Balestrino/UV-Curing/CuringBox/CuringBox.pptx

## CuringBox

Light source and Bioreactor holder

## Slide 2

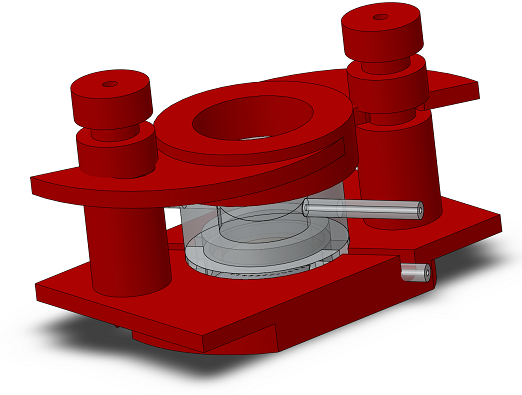
[picture p1: figure]
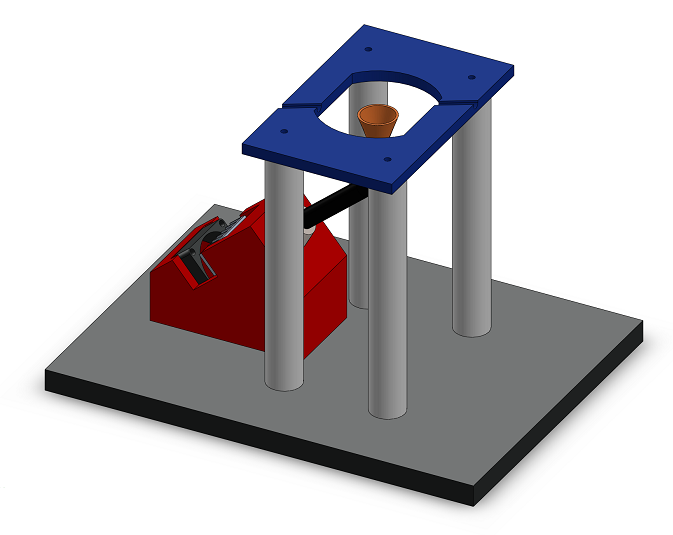
[picture p2: figure]

## Slide 3

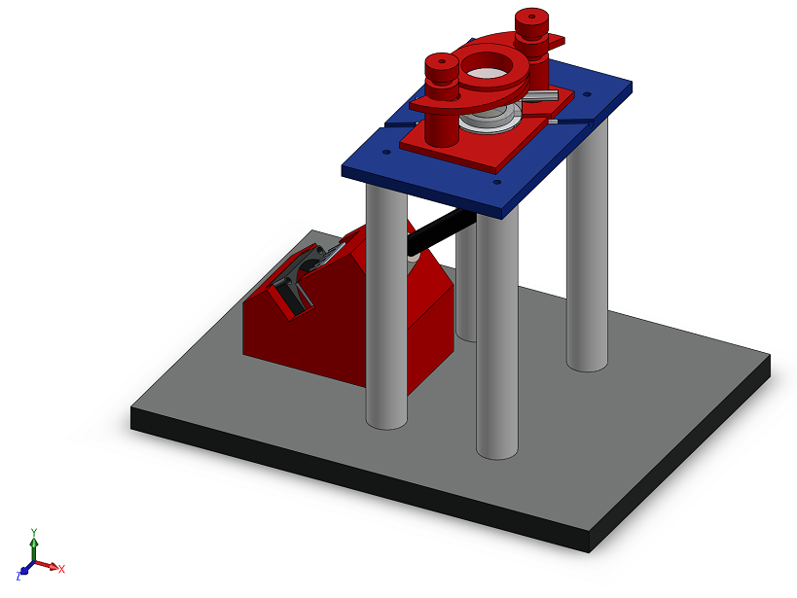
[picture p3: figure]

## Slide 4

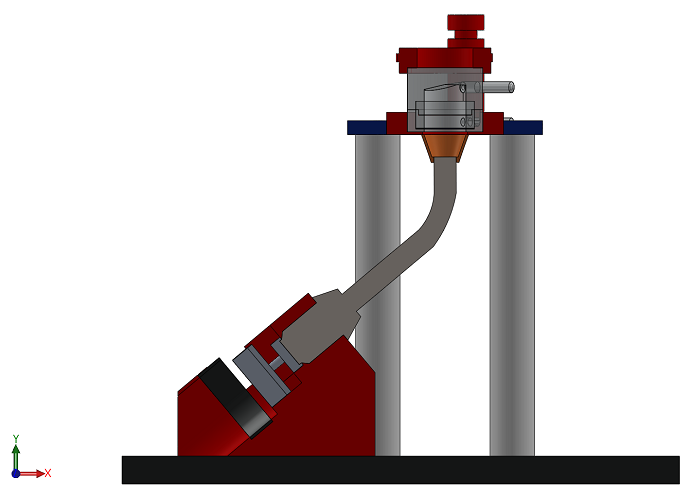
[picture p4: figure]

Blue LED + heatsink

Dissipation fan

Light guide
