Balestrino/UV-Curing/CuringBox/LiveBox 1/Patent/Claim list.docx

1. Technical description
  a. Technical drawings of bioreactor components + written description
  b. Modes of use
2. Claims
  a. Removable glass bottom allowing for
    i. direct cell culture on it
    ii. in situ polymerisation of photo-crosslinkable materials (hydrogels, …)
    iii. in-situ photo-stimulation of light-sensitive materials (hydrogel, sensors, ROS generators, …)
    iv. Live imaging through transparent bottom during dynamic cultures of 2D/3D cellular constructs cultivated on the glass discs or onto the membrane
  b. Support for 2D/3D static and dynamic cell cultures with a sensorised culture chamber resembling 24 well plate volume allowing for cell expansion (i.e. cell confluence) and subsequent dynamic cultures in two different configurations
    i. Conventional culture on the well bottom
    ii. Transwell configuration mimicking 12 transwell insert surface
    iii. Monitoring through electrical measures (TEER measurements, required only for interface cultures)
  c. Flow: 2 inlets / 2 outlets (one inlet/outlet pair above the interface and one below)
    i. Single side
    ii. Double side (ALI or LLI cell culture)
    iii. 3D Construct perfusion (sigmoidal → upper in/lower out preferred embodiment)
  d. Re-usable glass housing
3. SoA
  a. Sensorised culture supports allowing for both
    i. cell expansion (i.e. cell confluence) and subsequent dynamic cultures without the need of transferring pre-expanded construct from static culture devices
    ii. Live imaging

Live Imaging = in situ imaging of the three-dimensional (3D) culture environment using microscopy. The visualisation of cell response to their environment, in real time, helps to further elucidate the influences of biomaterial surface features, scaffold architectures, and culture parameters (e.g. flow induced shear) on cell response and growth of new tissue(s).
