Balestrino/UV-Curing/CuringBox/LiveBox 1/Figure A - TB.pptx

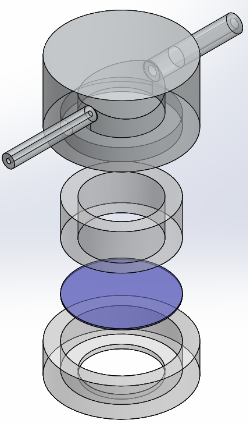
[picture p12: figure]

4

3

2

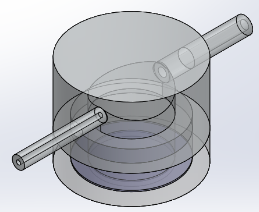
[picture p13: figure]

1

5
