Balestrino/UV-Curing/CuringBox/LiveBox 1/Figure B - LiveBox1.pptx

5

3

2

1

7


6

4

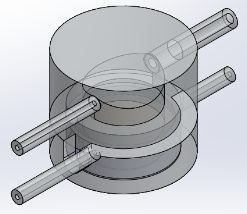
[picture p14: figure]
