Balestrino/UV-Curing/CuringBox/TB/3D view TB esploso.tif

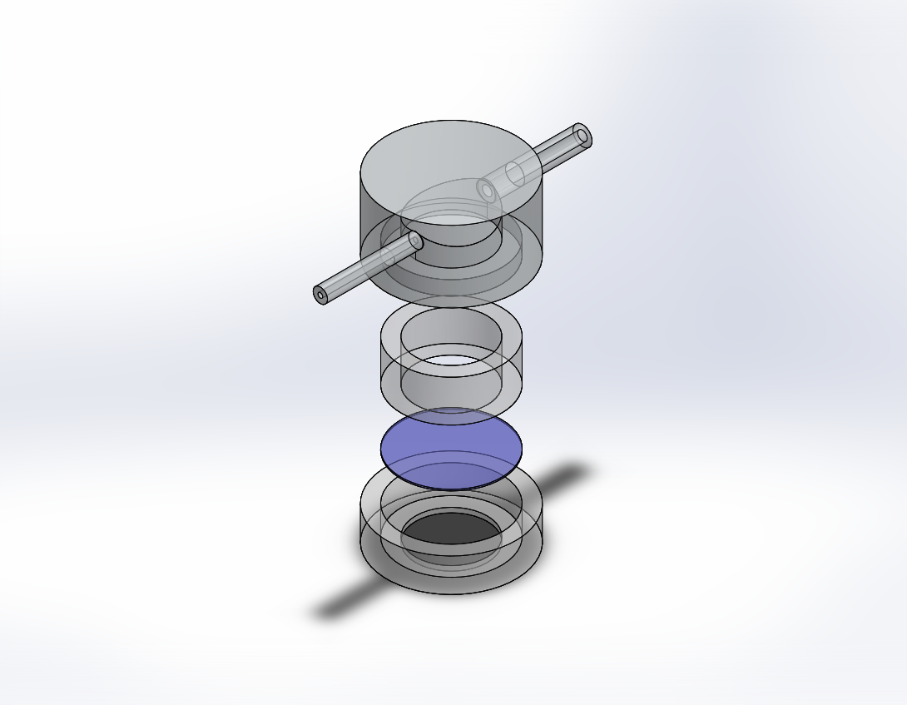
CuringBox/TB/3D view TB esploso.tif
