Balestrino/UV-Curing/CuringBox/TB/3D view TB.TIF

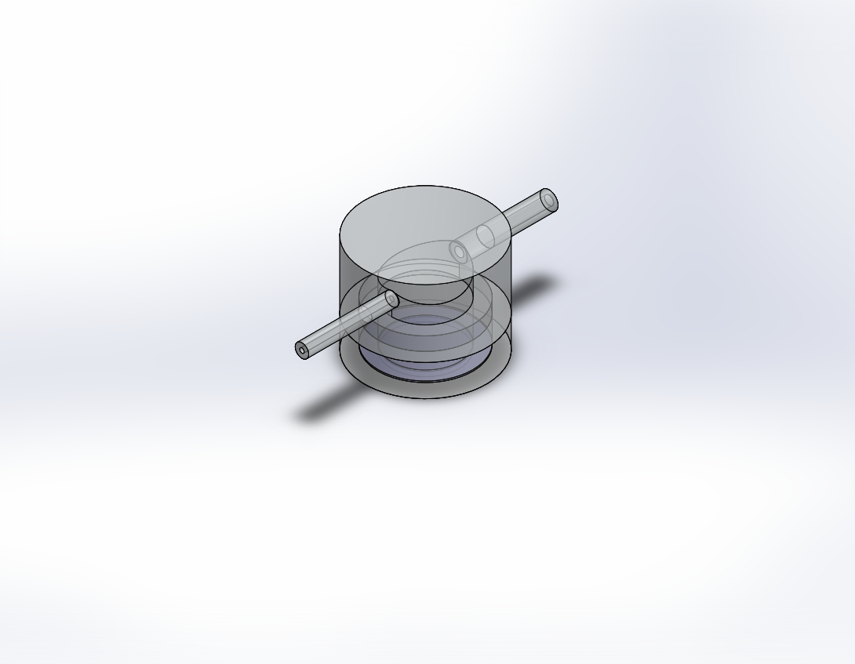
CuringBox/TB/3D view TB.TIF
