Balestrino/UV-Curing/CuringBox/Light source/Assembly - Light source.SLDASM

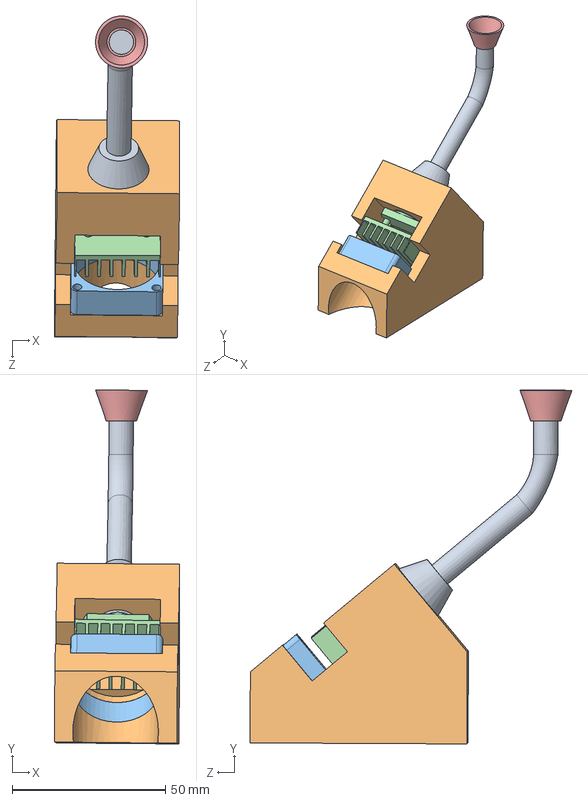
[picture p17: CAD file, 2013-10-29]
CuringBox/Light source/Assembly - Light source.SLDASM
41.0 x 115.5 x 105.1 mm
OpticFiber
Base
Dissipation fan
LED+heatsink
Rubber cone
