Balestrino/UV-Curing/CuringBox/LiveBox 1/PDMS assembly/3D view live box 1.SLDASM

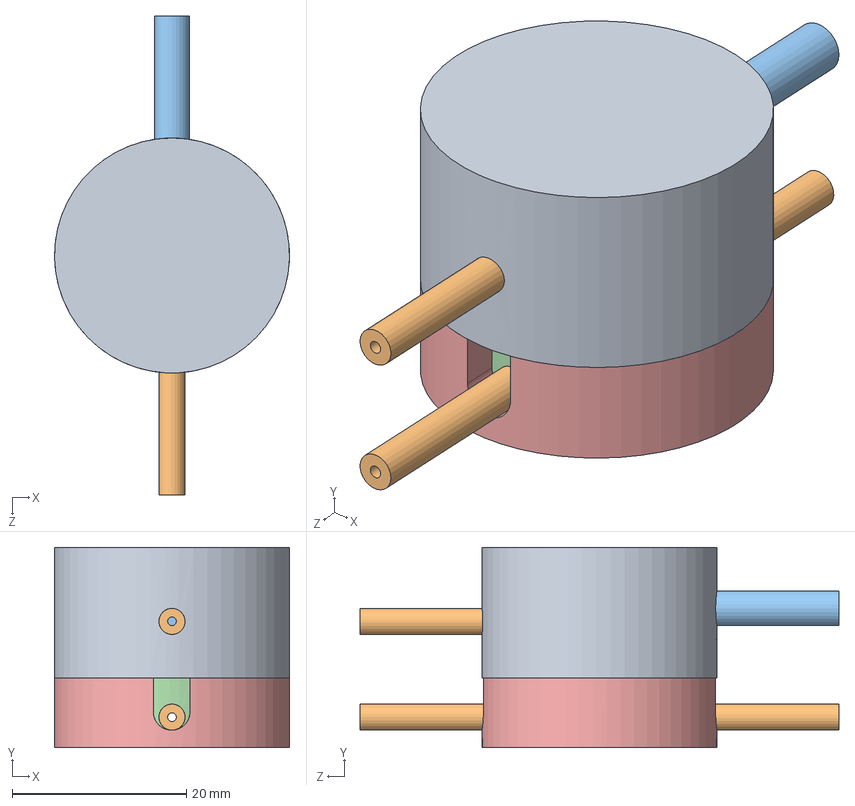
[picture p18: CAD file, 2013-10-29]
CuringBox/LiveBox 1/PDMS assembly/3D view live box 1.SLDASM
27.0 x 23.0 x 55.0 mm
Top
3x1 x 3
4x2
Inner bottom
Bottom
Inner up
glass bottom
Membrane
