Balestrino/UV-Curing/DrivingBox/arduino nano290313/MINIUSB - MEASURED.SLDASM

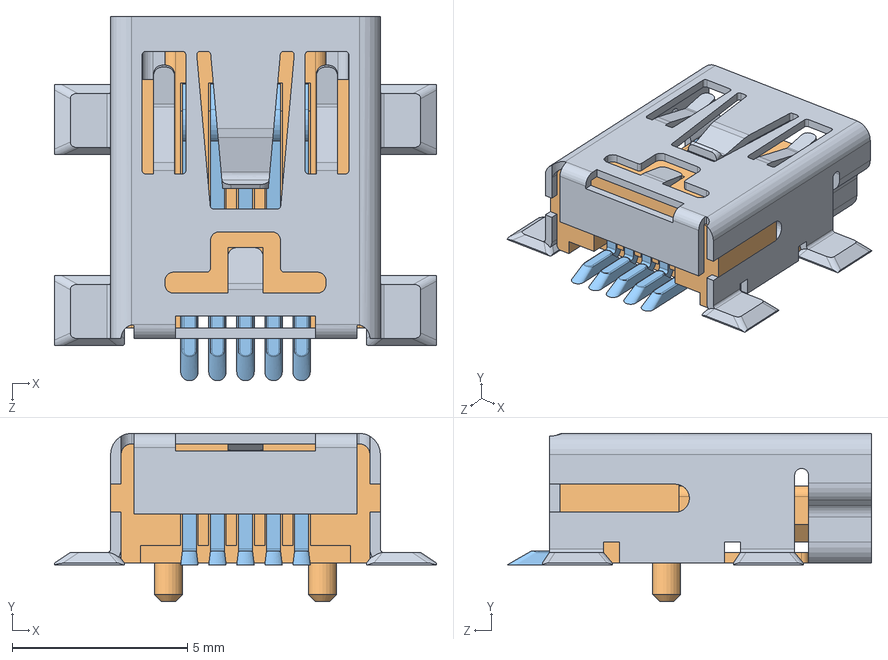
[picture p19: CAD file, 2013-10-29]
DrivingBox/arduino nano290313/MINIUSB - MEASURED.SLDASM
10.9 x 4.80 x 10.4 mm
MINIUSBSHELL
MINIUSBCORE
MINI USB CONTACT x 5
