Balestrino/UV-Curing/CuringBox/Assembly-CuringBox.SLDASM

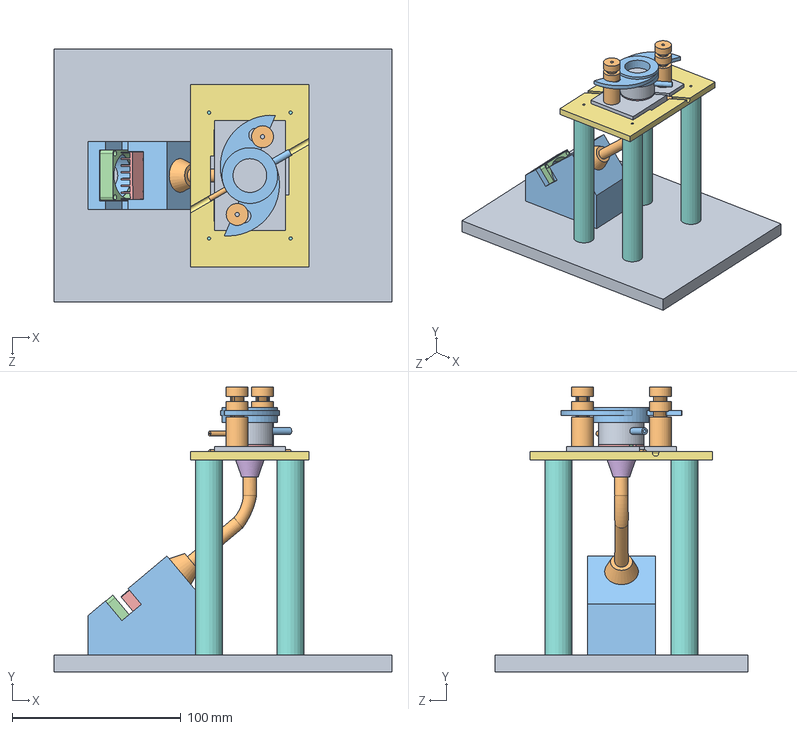
[picture p20: CAD file, 2013-10-29]
CuringBox/Assembly-CuringBox.SLDASM
200.0 x 168.5 x 150.0 mm
Basement
OpticFiber
Base
Dissipation fan
LED+heatsink
Rubber cone
Bioreactor holder
Column x 4
Top
3x1 x 3
4x2
Inner bottom
Bottom
Inner up
glass bottom
Membrane
mycroscope clamp base
mycroscope clamp colonna x 4
mycroscope clamp ali LVB1
