Balestrino/UV-Curing/CuringBox/LiveBox 1/PDMS assembly/3Dview-Inner bottom.SLDPRT.SLDASM

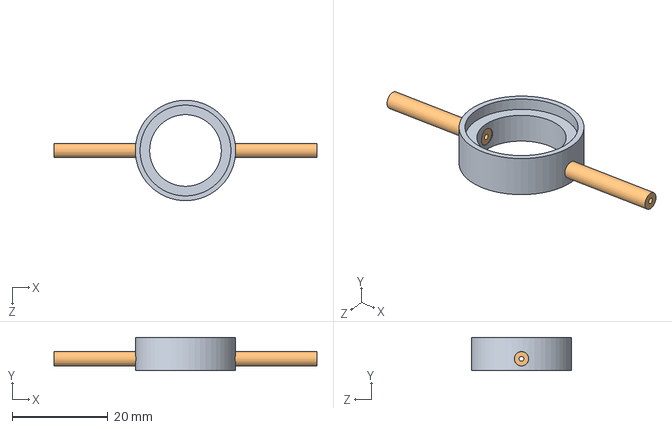
[picture p21: CAD file, 2013-10-29]
CuringBox/LiveBox 1/PDMS assembly/3Dview-Inner bottom.SLDPRT.SLDASM
55.0 x 7.00 x 21.0 mm
Inner bottom
3x1 x 2
