Balestrino/UV-Curing/CuringBox/TB/3D view TB.SLDASM

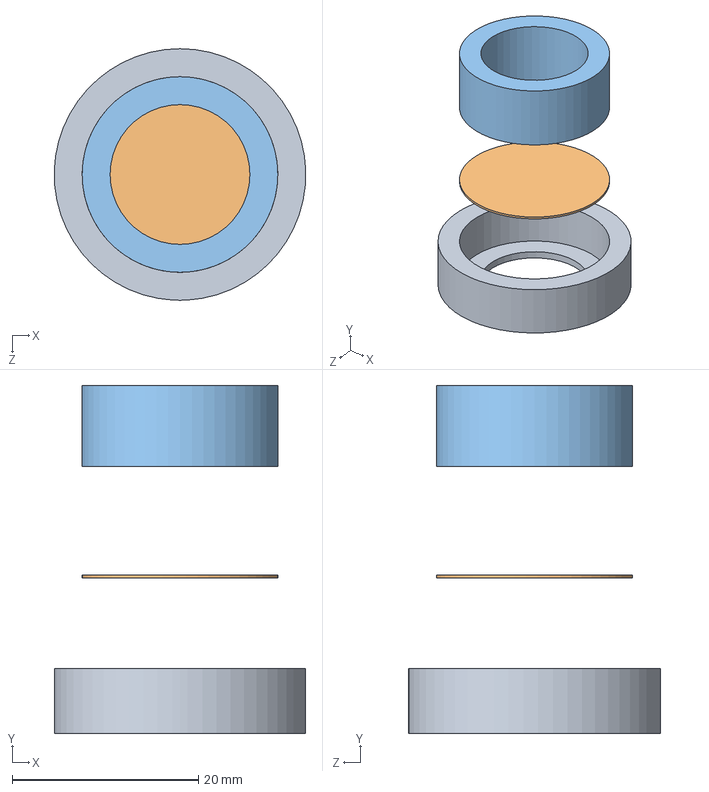
[picture p22: CAD file, 2013-10-29]
CuringBox/TB/3D view TB.SLDASM
27.0 x 37.3 x 27.0 mm
TB-Bottom
glass bottom
TB-Inner
