Balestrino/UV-Curing/DrivingBox/arduino nano290313/arduino nano.SLDASM

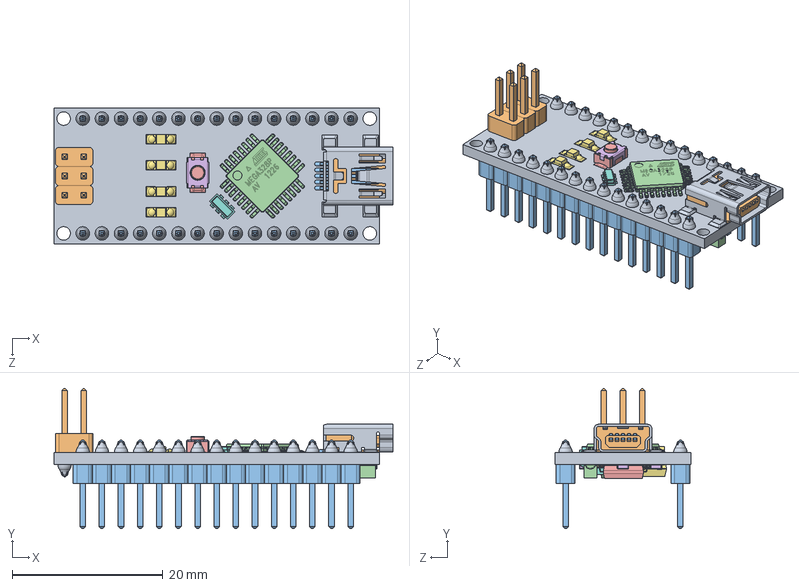
[picture p23: CAD file, 2013-10-29]
DrivingBox/arduino nano290313/arduino nano.SLDASM
45.0 x 18.6 x 18.0 mm
nano-board
2pin_header__02 x 3
15pin_header__ x 2
atmega328
ftdi FT232rl
smt_resistor222 x 5
led x 4
16mhz crystal - measured
MINIUSBSHELL
MINIUSBCORE
MINI USB CONTACT x 5
cap106C x 2
reset core
reset shell
nano - reg
NANO DIODE
189 RESISTOR PACK
102 RESISTOR PACK
