Balestrino/UV-Curing/CuringBox/Bioreactor holder/mycroscope clamp 3D + LVB1.SLDPRT.SLDASM

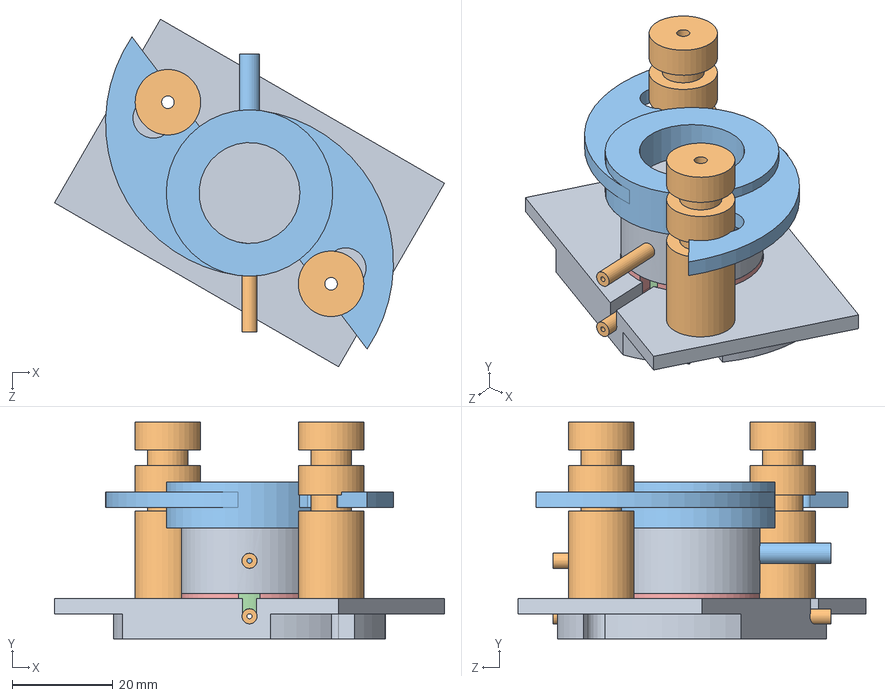
[picture p24: CAD file, 2013-10-29]
CuringBox/Bioreactor holder/mycroscope clamp 3D + LVB1.SLDPRT.SLDASM
77.3 x 43.0 x 68.9 mm
Top
3x1 x 3
4x2
Inner bottom
Bottom
Inner up
glass bottom
Membrane
mycroscope clamp base
mycroscope clamp colonna x 2
mycroscope clamp ali LVB1
