Balestrino/UV-Curing/CuringBox/LiveBox 1/PDMS assembly/3D view bottom.SLDASM

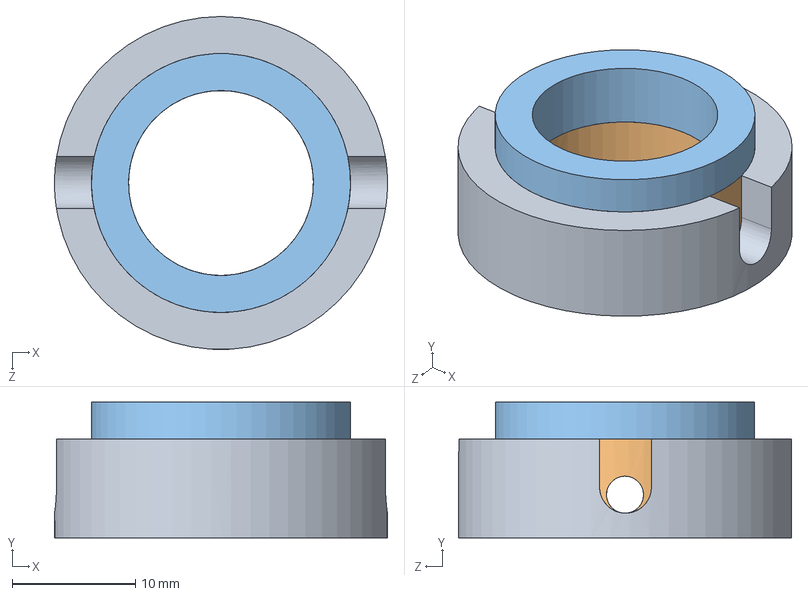
[picture p25: CAD file, 2013-10-29]
CuringBox/LiveBox 1/PDMS assembly/3D view bottom.SLDASM
27.0 x 11.0 x 27.0 mm
Bottom
Inner bottom
Inner up
