Balestrino/UV-Curing/CuringBox/LiveBox 1/PDMS assembly/3Dview-Top.SLDPRT.SLDASM

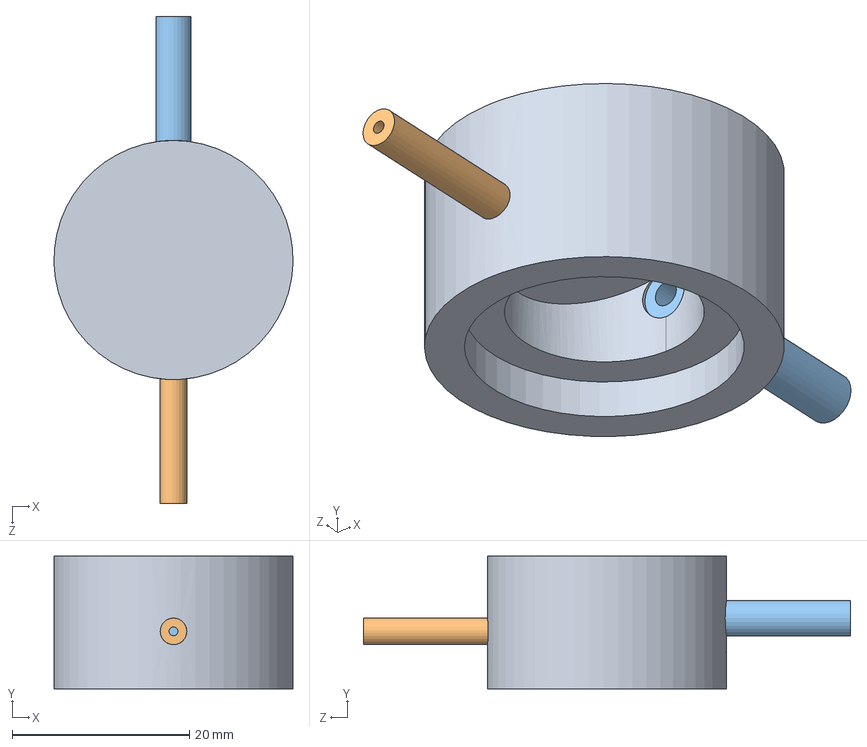
[picture p26: CAD file, 2013-10-29]
CuringBox/LiveBox 1/PDMS assembly/3Dview-Top.SLDPRT.SLDASM
27.0 x 15.0 x 55.0 mm
Top
3x1
4x2
