Balestrino/UV-Curing/CuringBox/LiveBox 1/mycroscope clamp 3D.SLDPRT.SLDASM

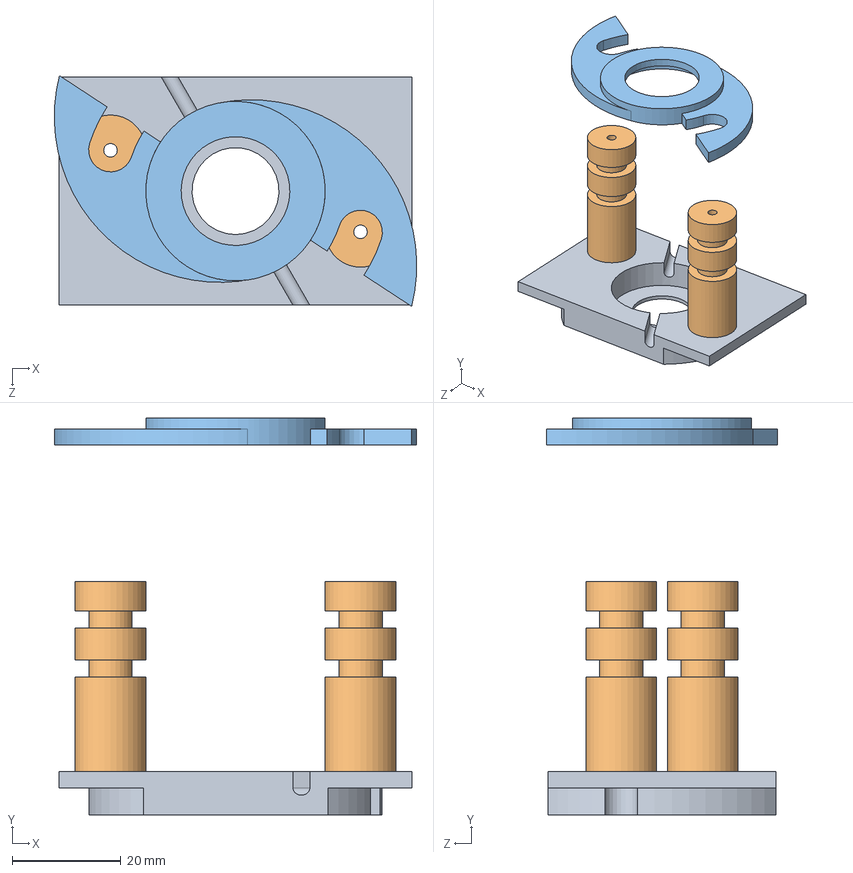
[picture p27: CAD file, 2013-10-29]
CuringBox/LiveBox 1/mycroscope clamp 3D.SLDPRT.SLDASM
66.7 x 73.0 x 42.5 mm
mycroscope clamp base
mycroscope clamp colonna x 2
mycroscope clamp ali
