Balestrino/UV-Curing/CuringBox/Bioreactor holder/Assembly-bioreact holder+clamp base+columns.SLDASM

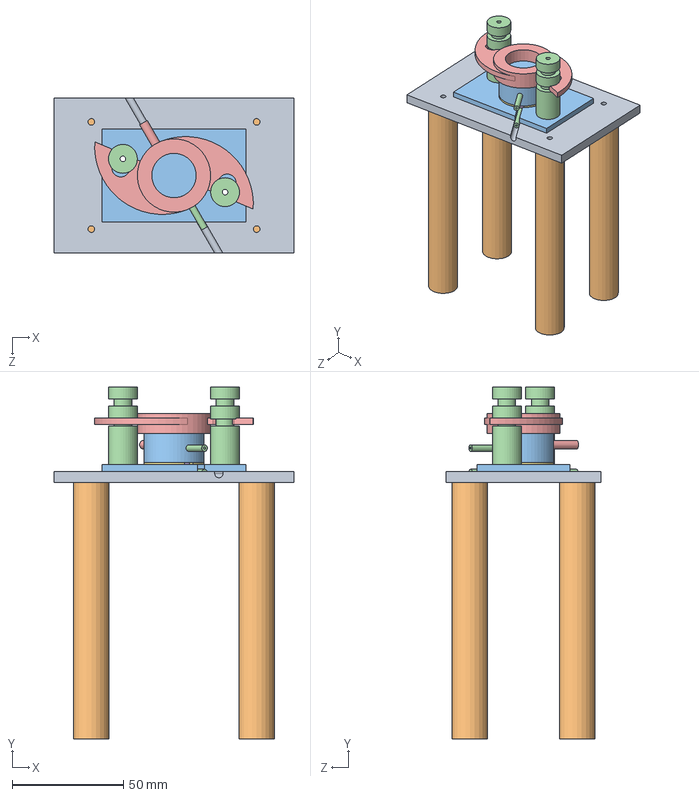
[picture p29: CAD file, 2013-10-29]
CuringBox/Bioreactor holder/Assembly-bioreact holder+clamp base+columns.SLDASM
108.0 x 158.5 x 70.0 mm
Bioreactor holder
Column x 4
Top
3x1 x 3
4x2
Inner bottom
Bottom
Inner up
glass bottom
Membrane
mycroscope clamp base
mycroscope clamp colonna x 2
mycroscope clamp ali LVB1
