Balestrino/UV-Curing/CuringBox/Bioreactor holder/bioreact holder+clamp base.SLDASM

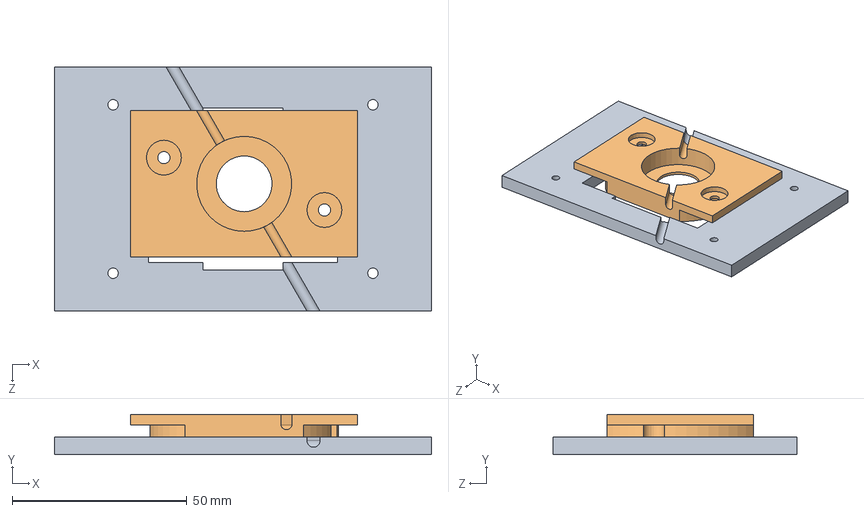
[picture p30: CAD file, 2013-10-29]
CuringBox/Bioreactor holder/bioreact holder+clamp base.SLDASM
108.0 x 11.5 x 70.0 mm
Bioreactor holder
mycroscope clamp base
