Balestrino/UV-Curing/DrivingBox/arduino nano290313/reset button.SLDASM

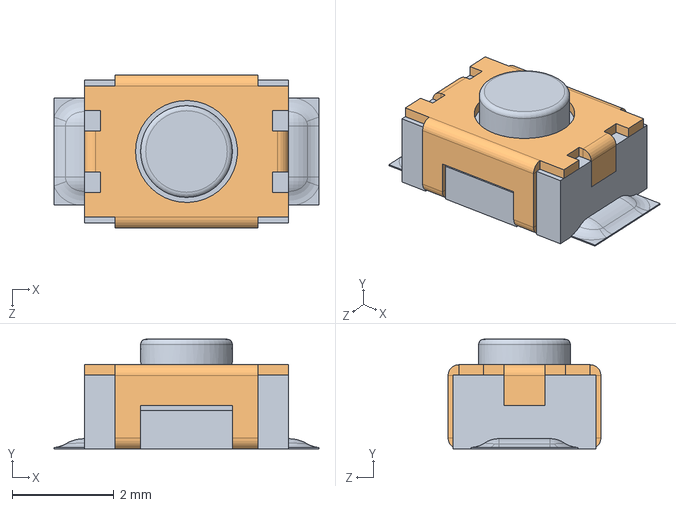
[picture p32: CAD file, 2013-10-29]
DrivingBox/arduino nano290313/reset button.SLDASM
5.20 x 2.15 x 3.00 mm
reset core
reset shell
