Balestrino/UV-Curing/CuringBox/Basement.SLDPRT

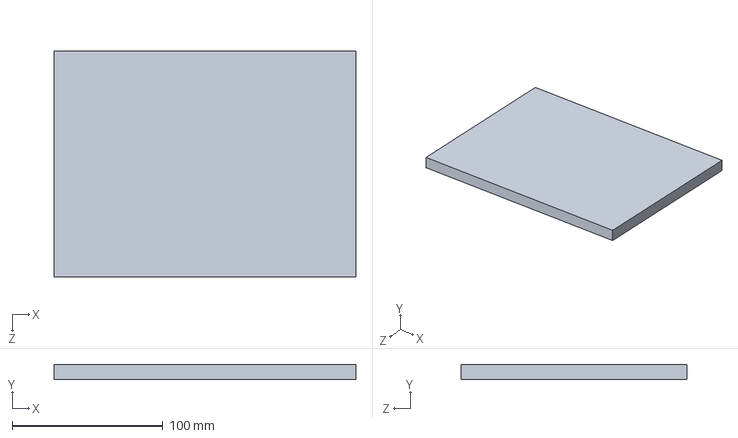
[picture p33: CAD file, 2013-10-29]
CuringBox/Basement.SLDPRT
200.0 x 10.0 x 150.0 mm
