Balestrino/UV-Curing/CuringBox/Bioreactor holder/mycroscope clamp colonna.SLDPRT

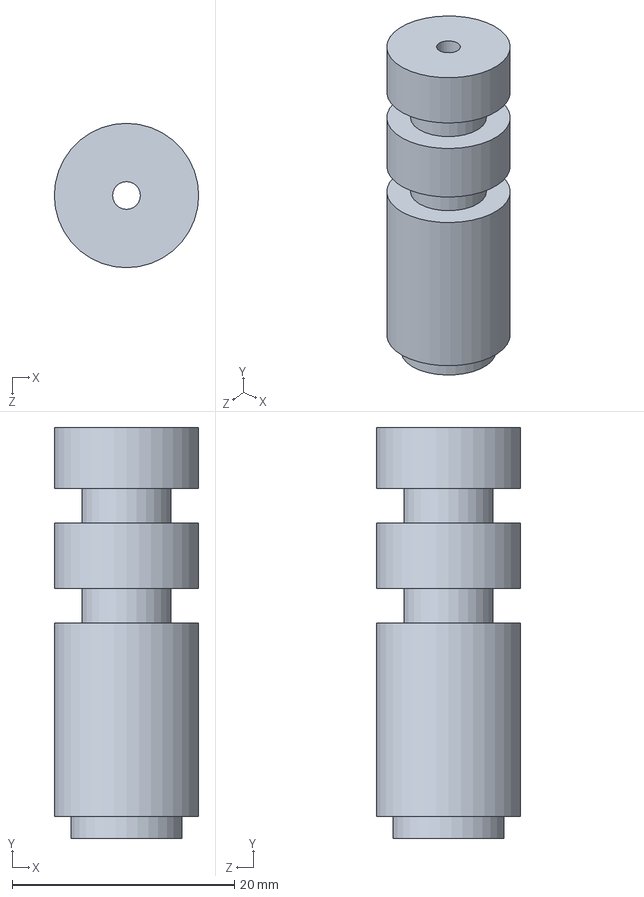
[picture p34: CAD file, 2013-10-29]
CuringBox/Bioreactor holder/mycroscope clamp colonna.SLDPRT
13.0 x 37.0 x 13.0 mm
