Balestrino/UV-Curing/CuringBox/LiveBox 1/mycroscope clamp base.SLDPRT

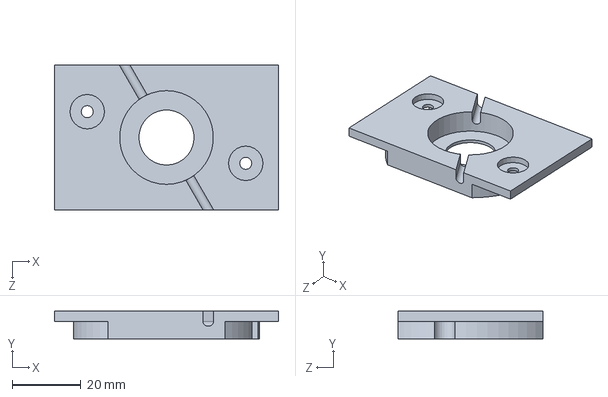
[picture p35: CAD file, 2013-10-29]
CuringBox/LiveBox 1/mycroscope clamp base.SLDPRT
65.0 x 8.00 x 42.0 mm
