Balestrino/UV-Curing/CuringBox/LiveBox 1/PDMS parts/Inner bottom.SLDPRT

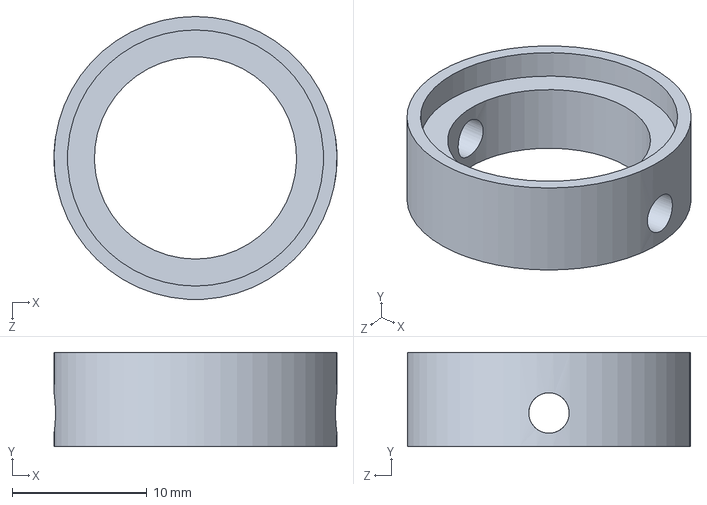
[picture p36: CAD file, 2013-10-29]
CuringBox/LiveBox 1/PDMS parts/Inner bottom.SLDPRT
21.0 x 7.00 x 21.0 mm
