Balestrino/UV-Curing/CuringBox/TB/TB-Bottom.SLDPRT

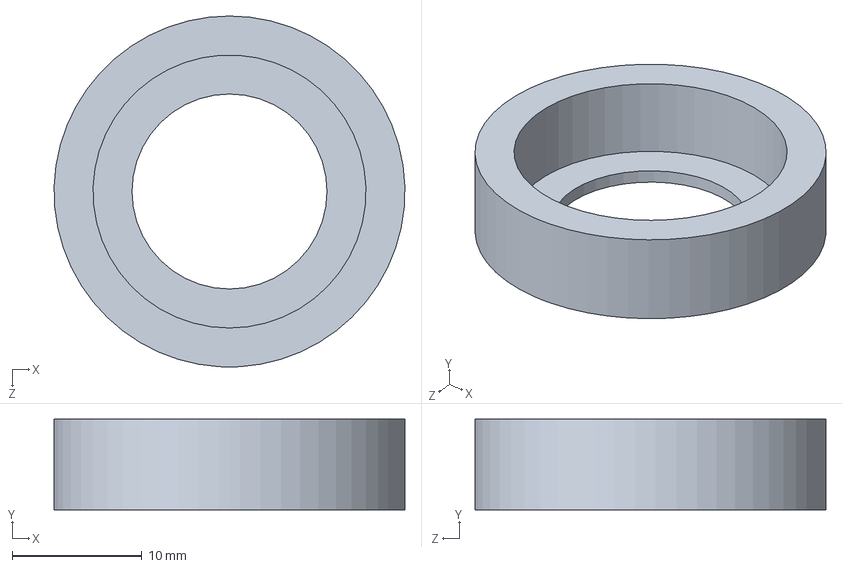
[picture p37: CAD file, 2013-10-29]
CuringBox/TB/TB-Bottom.SLDPRT
27.0 x 7.00 x 27.0 mm
