Balestrino/UV-Curing/DrivingBox/Connector.SLDPRT

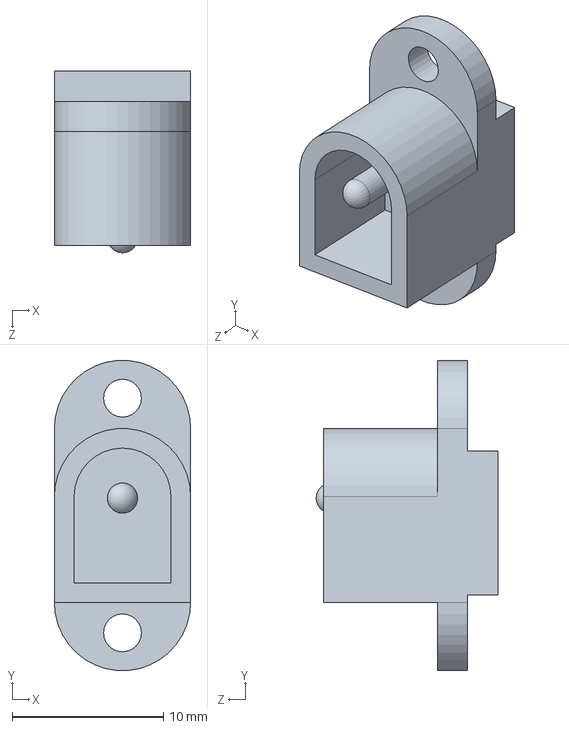
[picture p38: CAD file, 2013-10-29]
DrivingBox/Connector.SLDPRT
9.00 x 20.5 x 12.0 mm
