Balestrino/UV-Curing/CuringBox/Bioreactor holder/Giorgio-Bioreactor holder-HiRes.STL

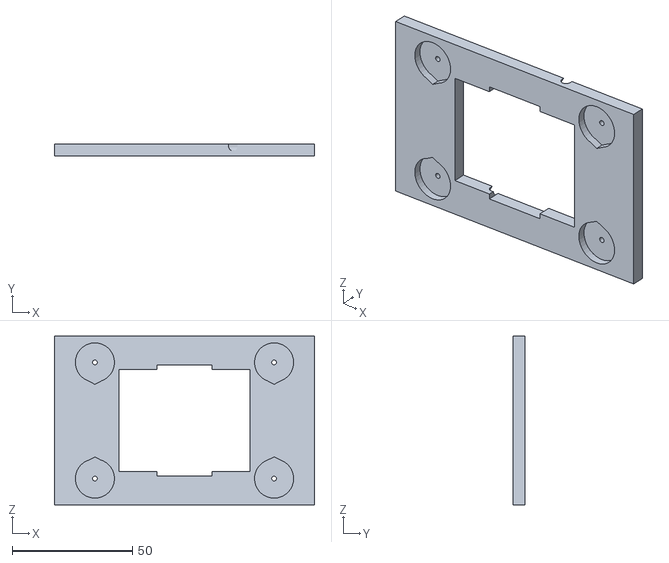
[picture p39: CAD file, 2013-10-29]
CuringBox/Bioreactor holder/Giorgio-Bioreactor holder-HiRes.STL
108.0 x 5.00 x 70.0
