Balestrino/UV-Curing/CuringBox/Light source/LED+heatsink.SLDPRT

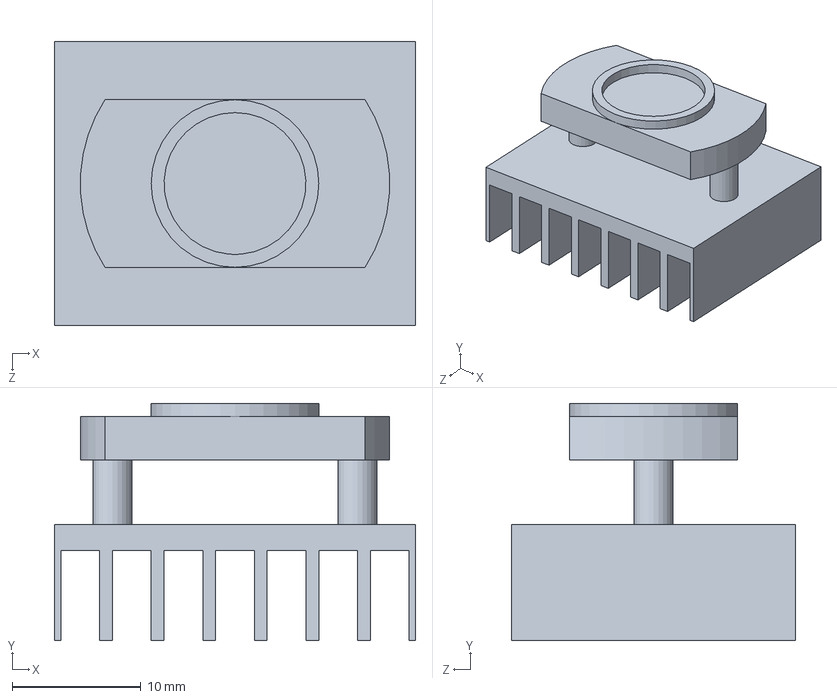
[picture p40: CAD file, 2013-10-29]
CuringBox/Light source/LED+heatsink.SLDPRT
28.0 x 18.4 x 22.0 mm
