Balestrino/UV-Curing/CuringBox/LiveBox 1/Membrane.SLDPRT

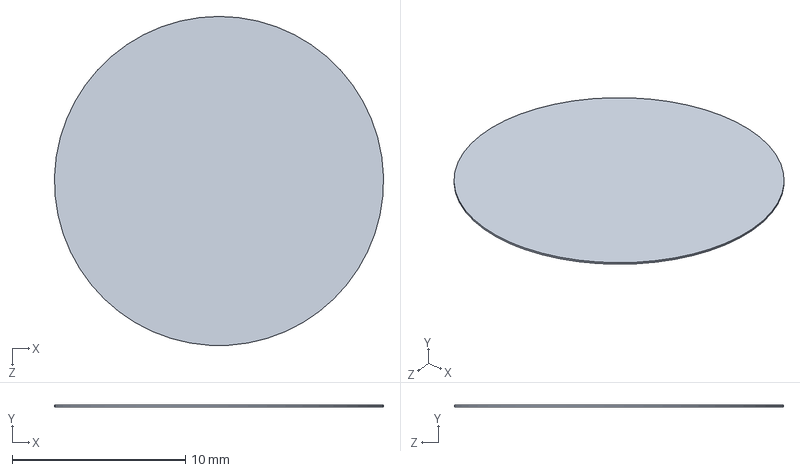
[picture p41: CAD file, 2013-10-29]
CuringBox/LiveBox 1/Membrane.SLDPRT
19.0 x 0.1 x 19.0 mm
