Balestrino/UV-Curing/CuringBox/LiveBox 1/PDMS parts/Top.SLDPRT

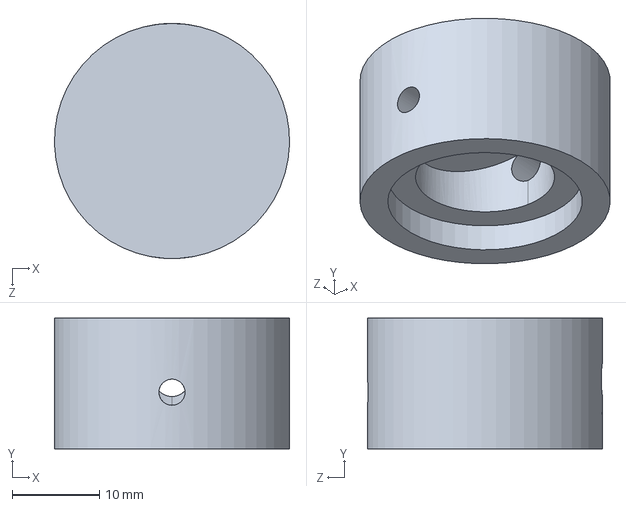
[picture p42: CAD file, 2013-10-29]
CuringBox/LiveBox 1/PDMS parts/Top.SLDPRT
27.0 x 15.0 x 27.0 mm
