Balestrino/UV-Curing/DrivingBox/Buttons.SLDPRT

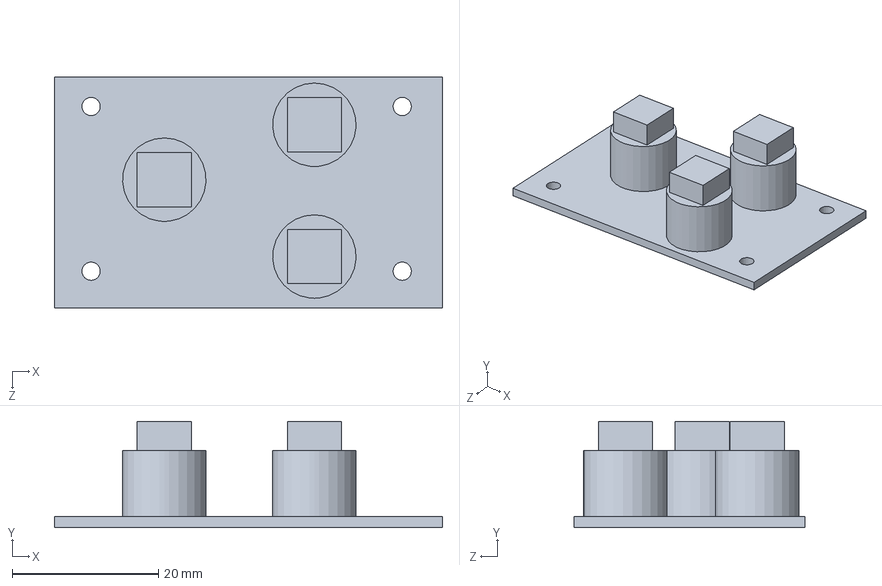
[picture p43: CAD file, 2013-10-29]
DrivingBox/Buttons.SLDPRT
53.0 x 14.5 x 31.5 mm
