Balestrino/UV-Curing/CuringBox/Light source/OpticFiber.SLDPRT

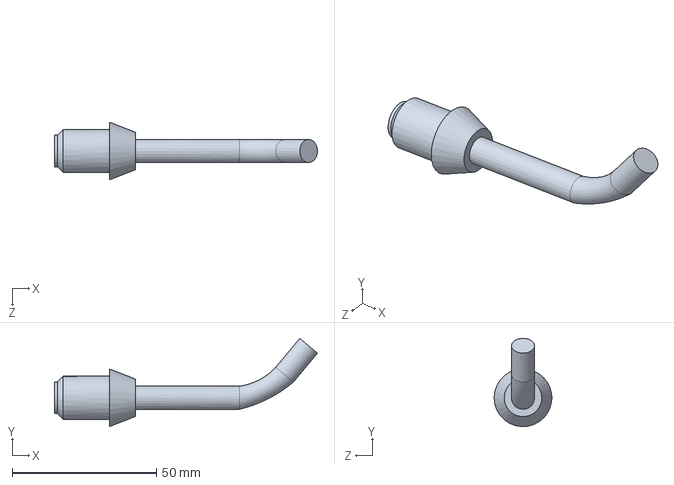
[picture p44: CAD file, 2013-10-29]
CuringBox/Light source/OpticFiber.SLDPRT
91.1 x 30.5 x 20.0 mm
