Balestrino/UV-Curing/CuringBox/LiveBox 1/mycroscope clamp ali TB.SLDPRT

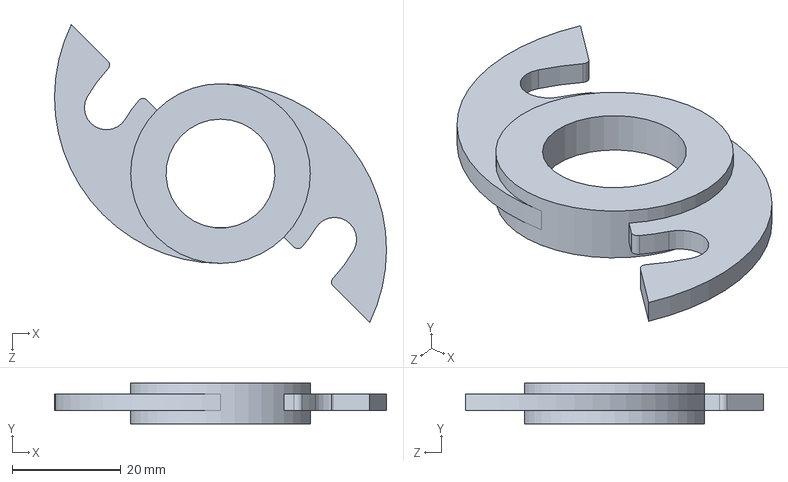
[picture p45: CAD file, 2013-10-29]
CuringBox/LiveBox 1/mycroscope clamp ali TB.SLDPRT
61.0 x 7.50 x 54.8 mm
