Balestrino/UV-Curing/CuringBox/LiveBox 1/PDMS parts/Inner up.SLDPRT

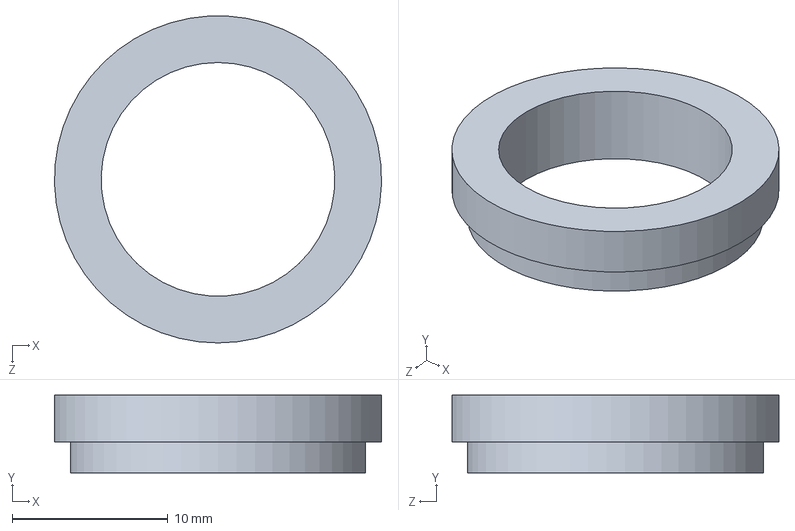
[picture p46: CAD file, 2013-10-29]
CuringBox/LiveBox 1/PDMS parts/Inner up.SLDPRT
21.0 x 5.00 x 21.0 mm
