Balestrino/UV-Curing/DrivingBox/arduino nano290313/cap106C.SLDPRT

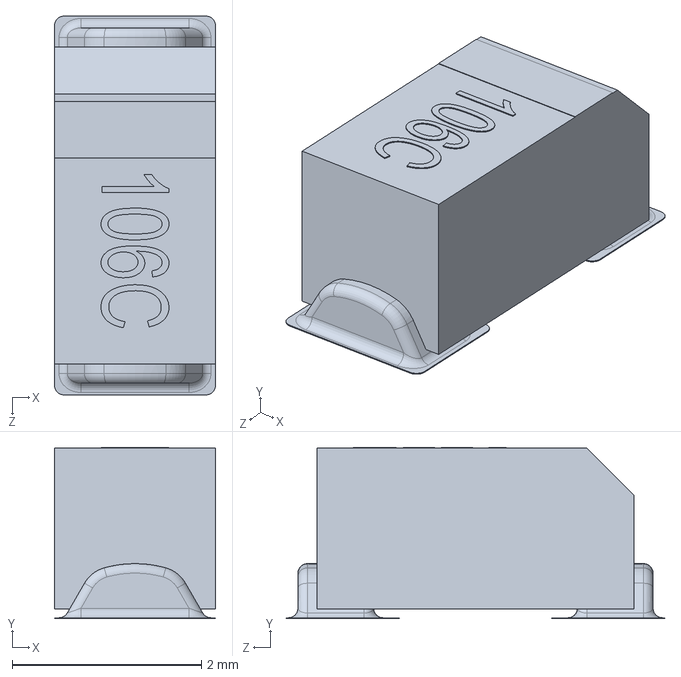
[picture p47: CAD file, 2013-10-29]
DrivingBox/arduino nano290313/cap106C.SLDPRT
1.70 x 1.81 x 4.00 mm
