Balestrino/UV-Curing/DrivingBox/Giorgio-Base.STL

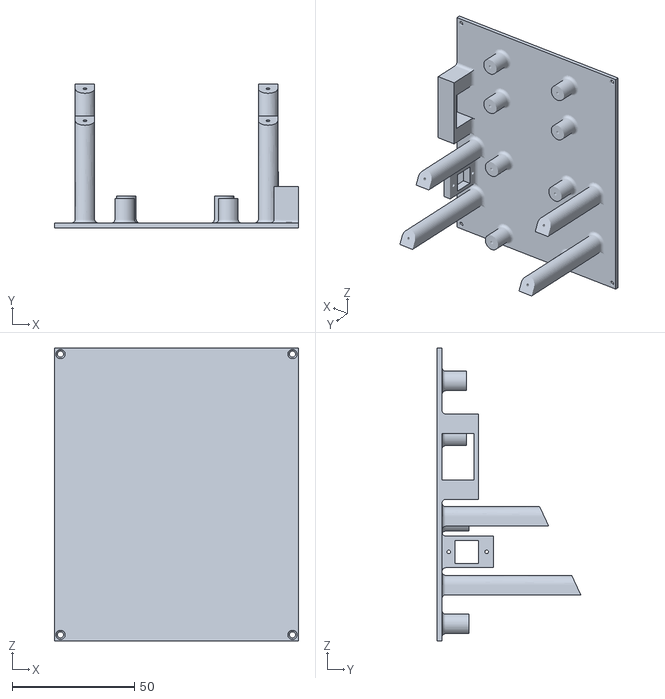
[picture p48: CAD file, 2013-10-29]
DrivingBox/Giorgio-Base.STL
100.0 x 58.8 x 120.0
