Balestrino/UV-Curing/CuringBox/Light source/Dissipation fan.SLDPRT

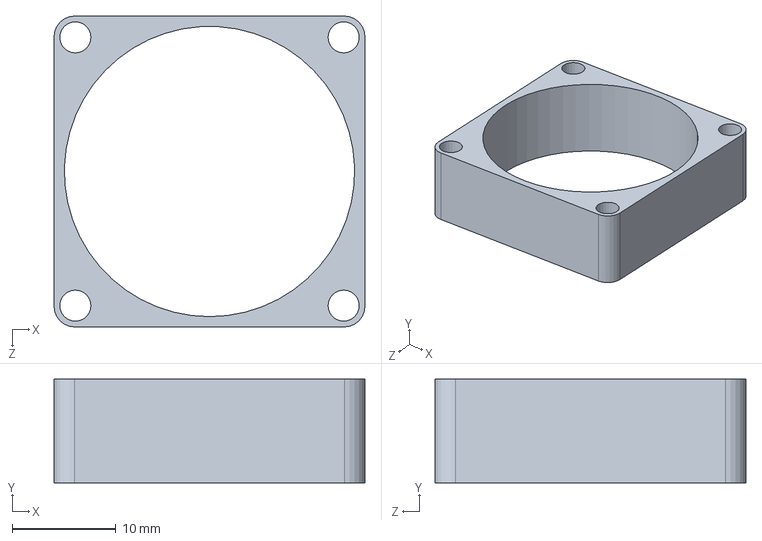
[picture p49: CAD file, 2013-10-29]
CuringBox/Light source/Dissipation fan.SLDPRT
30.0 x 10.0 x 30.0 mm
