Balestrino/UV-Curing/CuringBox/LiveBox 1/mycroscope clamp ali.SLDPRT

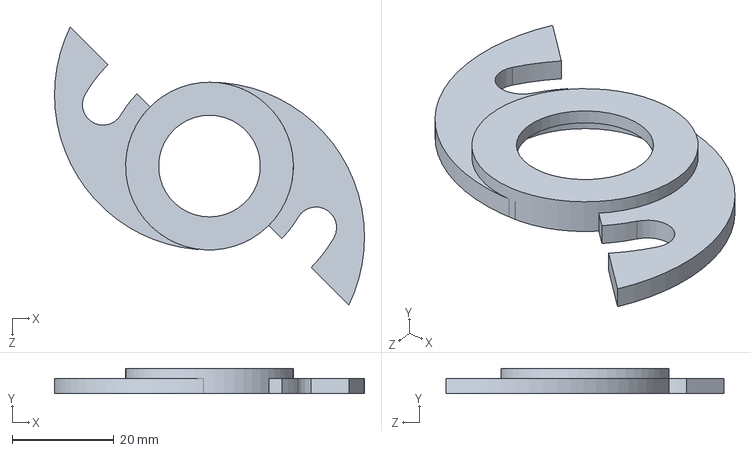
[picture p50: CAD file, 2013-10-29]
CuringBox/LiveBox 1/mycroscope clamp ali.SLDPRT
61.0 x 5.00 x 54.8 mm
