Balestrino/UV-Curing/CuringBox/LiveBox 1/PDMS parts/4x2.SLDPRT

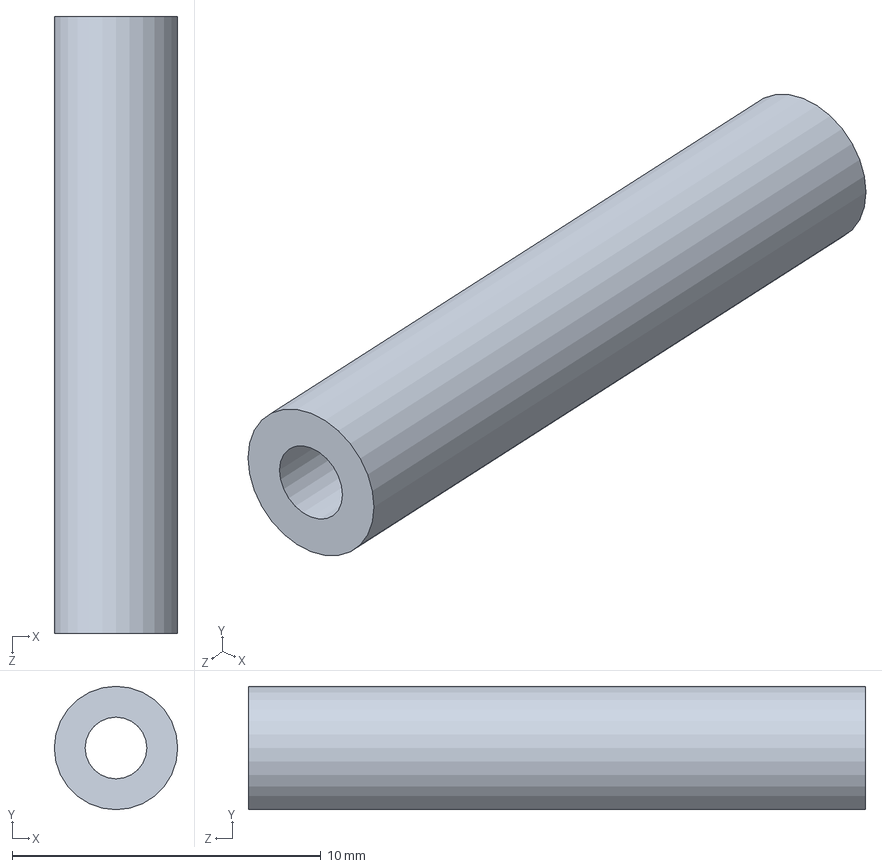
[picture p51: CAD file, 2013-10-29]
CuringBox/LiveBox 1/PDMS parts/4x2.SLDPRT
4.00 x 4.00 x 20.0 mm
