Balestrino/UV-Curing/CuringBox/TB/TB-Inner.SLDPRT

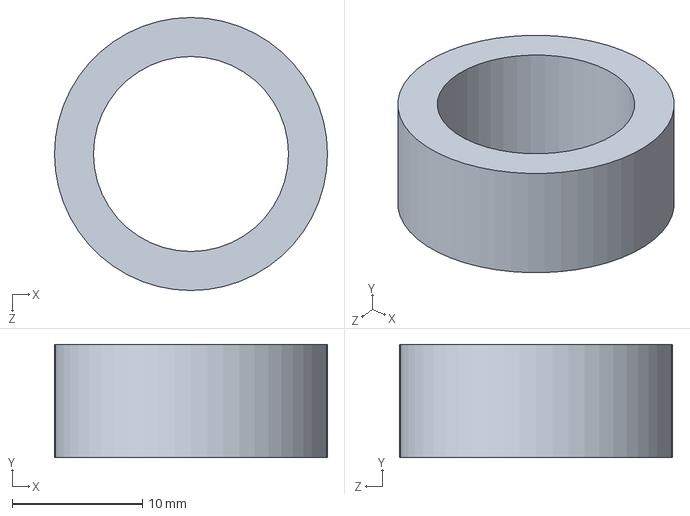
[picture p52: CAD file, 2013-10-29]
CuringBox/TB/TB-Inner.SLDPRT
21.0 x 8.70 x 21.0 mm
