Balestrino/UV-Curing/DrivingBox/arduino nano290313/MINIUSBCORE.SLDPRT

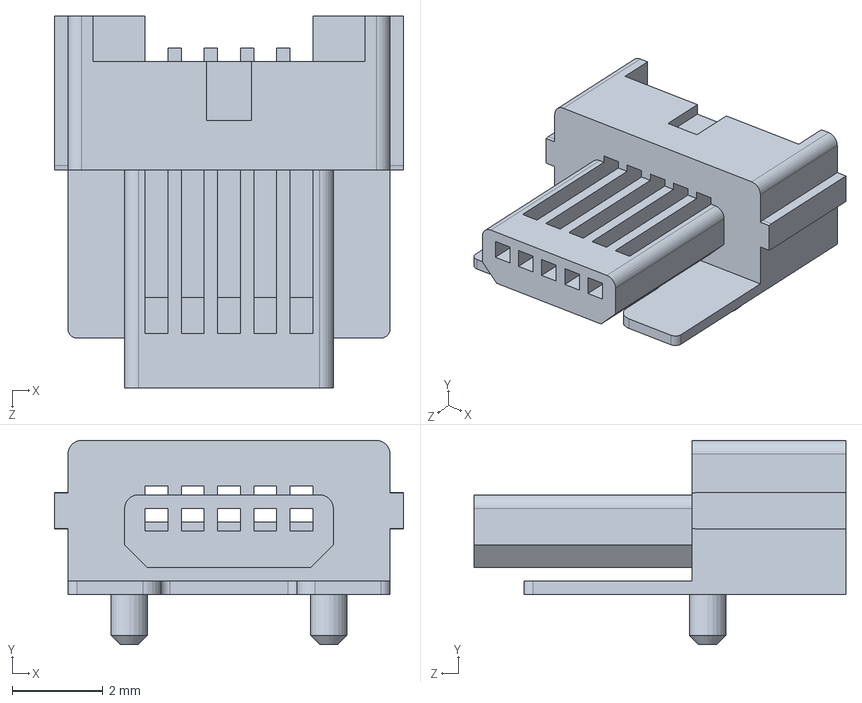
[picture p53: CAD file, 2013-10-29]
DrivingBox/arduino nano290313/MINIUSBCORE.SLDPRT
7.70 x 4.50 x 8.20 mm
