Balestrino/UV-Curing/DrivingBox/Switch.SLDPRT

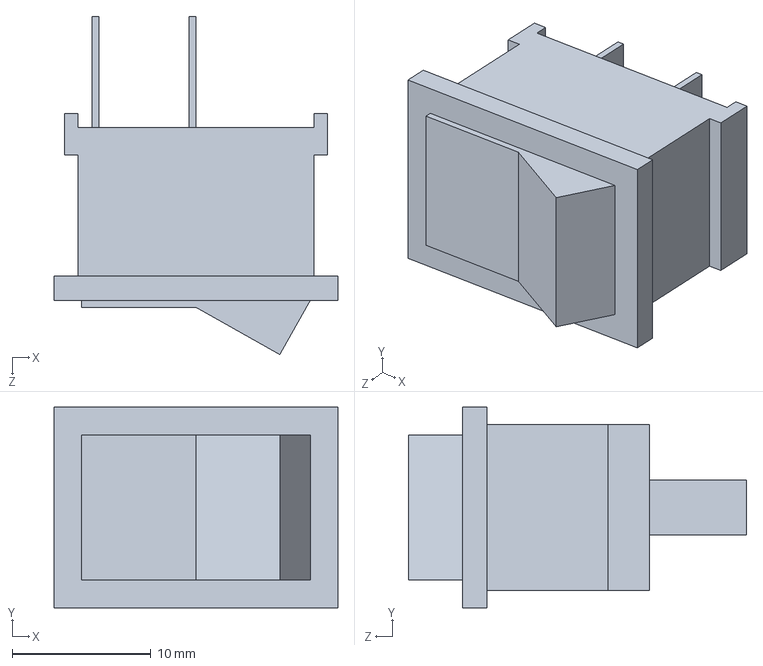
[picture p54: CAD file, 2013-10-29]
DrivingBox/Switch.SLDPRT
20.5 x 14.5 x 24.4 mm
