Balestrino/UV-Curing/CuringBox/Light source/Rubber cone.SLDPRT

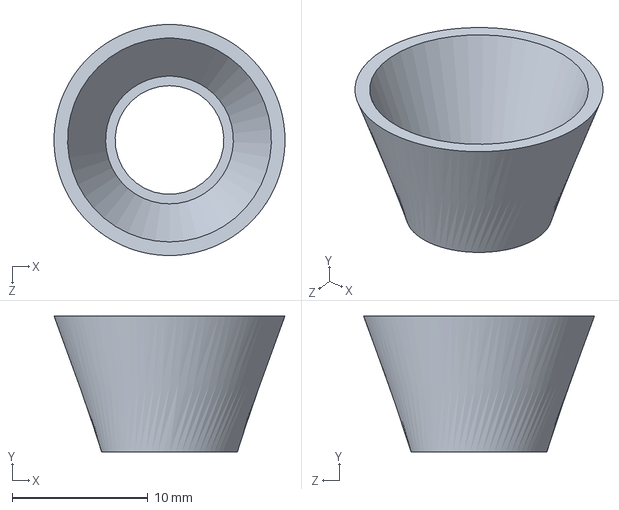
[picture p55: CAD file, 2013-10-29]
CuringBox/Light source/Rubber cone.SLDPRT
17.0 x 10.0 x 17.0 mm
