Balestrino/UV-Curing/CuringBox/LiveBox 1/Base componente bottom.SLDPRT

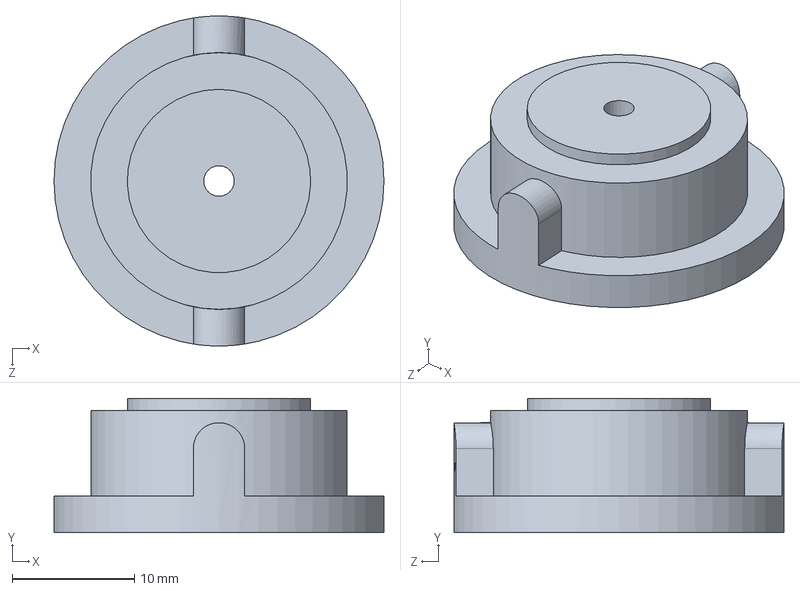
[picture p56: CAD file, 2013-10-29]
CuringBox/LiveBox 1/Base componente bottom.SLDPRT
27.0 x 11.0 x 27.0 mm
