Balestrino/UV-Curing/CuringBox/LiveBox 1/PDMS parts/Bottom.SLDPRT

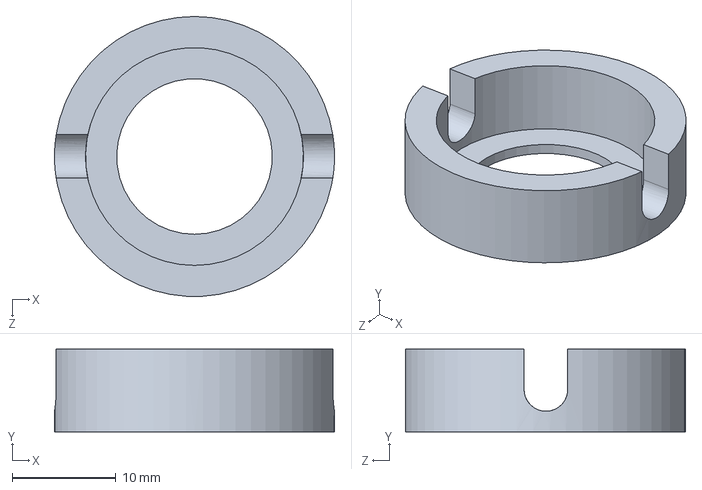
[picture p57: CAD file, 2013-10-29]
CuringBox/LiveBox 1/PDMS parts/Bottom.SLDPRT
27.0 x 8.00 x 27.0 mm
