Balestrino/UV-Curing/DrivingBox/arduino nano290313/led.SLDPRT

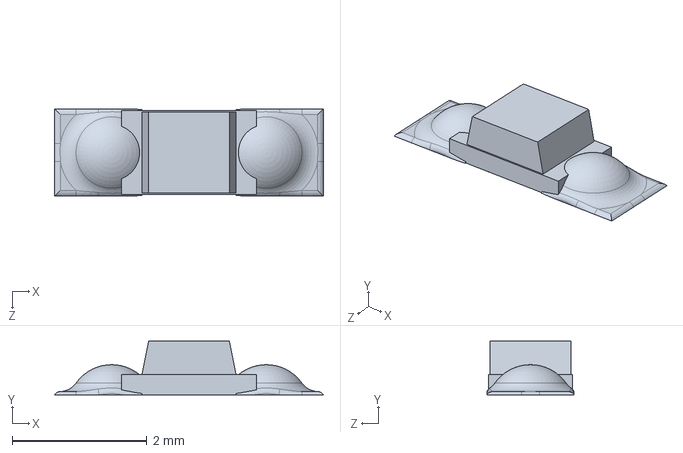
[picture p58: CAD file, 2013-10-29]
DrivingBox/arduino nano290313/led.SLDPRT
4.00 x 0.8 x 1.30 mm
