Balestrino/UV-Curing/DrivingBox/Giorgio-top.STL

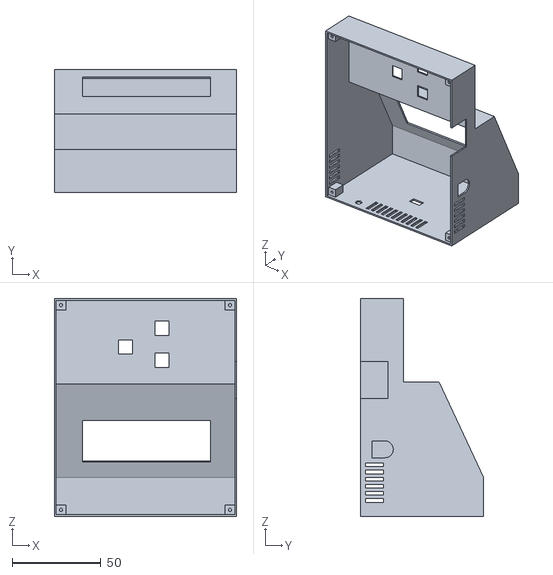
[picture p59: CAD file, 2013-10-29]
DrivingBox/Giorgio-top.STL
102.5 x 69.2 x 122.5
