Balestrino/UV-Curing/CuringBox/Bioreactor holder/mycroscope clamp ali LVB1.SLDPRT

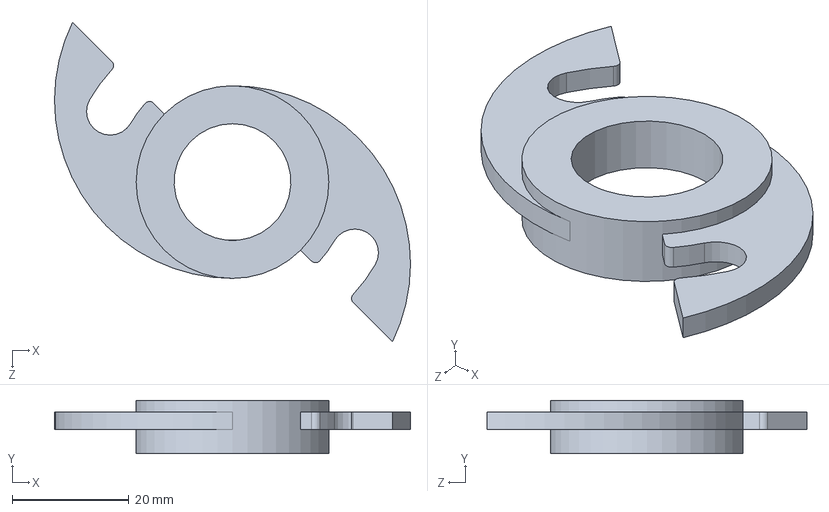
[picture p60: CAD file, 2013-10-29]
CuringBox/Bioreactor holder/mycroscope clamp ali LVB1.SLDPRT
61.0 x 9.10 x 54.8 mm
