Balestrino/UV-Curing/CuringBox/Light source/Base.SLDPRT

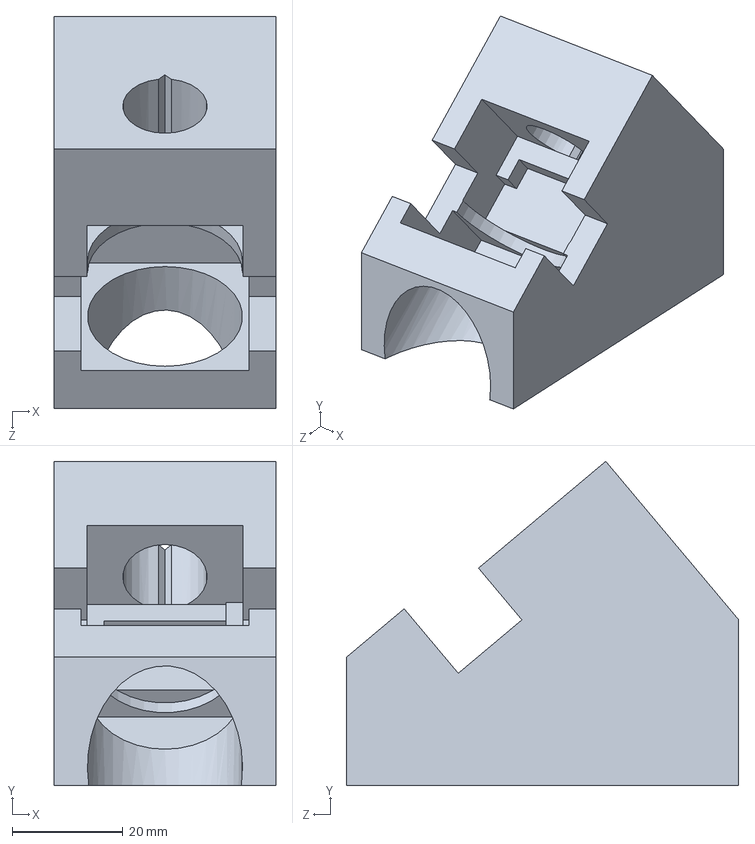
[picture p61: CAD file, 2013-10-29]
CuringBox/Light source/Base.SLDPRT
40.0 x 58.6 x 70.8 mm
