Balestrino/UV-Curing/CuringBox/TB/glass bottom.SLDPRT

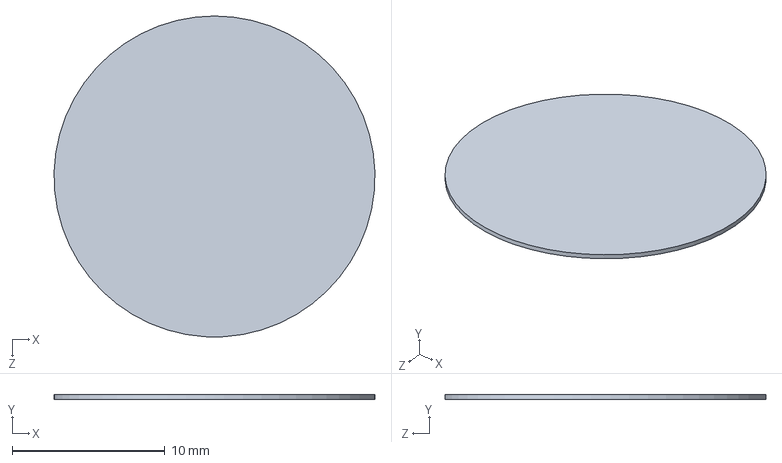
[picture p62: CAD file, 2013-10-29]
CuringBox/TB/glass bottom.SLDPRT
21.0 x 0.3 x 21.0 mm
