Balestrino/UV-Curing/DrivingBox/arduino nano290313/2pin_header__02.sldprt

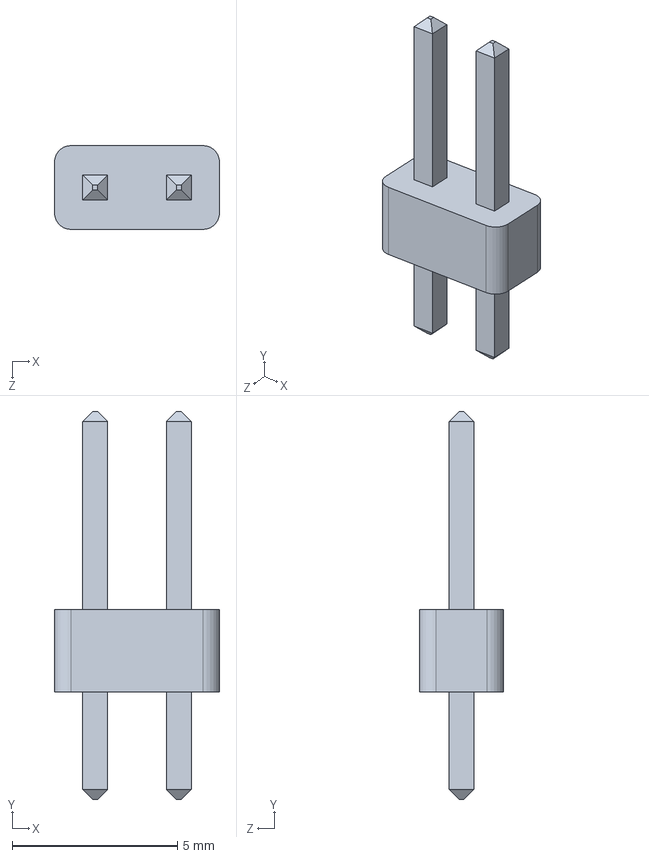
[picture p63: CAD file, 2013-10-29]
DrivingBox/arduino nano290313/2pin_header__02.sldprt
5.00 x 11.8 x 2.54 mm
