Balestrino/UV-Curing/CuringBox/LiveBox 1/Base componente centrale.SLDPRT

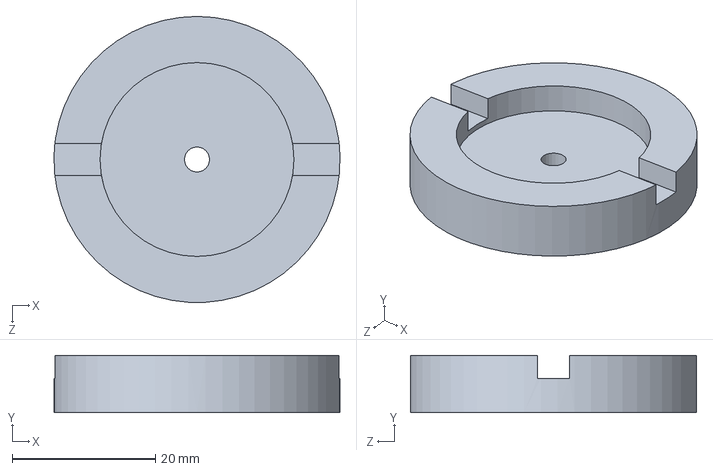
[picture p64: CAD file, 2013-10-29]
CuringBox/LiveBox 1/Base componente centrale.SLDPRT
40.0 x 8.00 x 40.0 mm
