Balestrino/UV-Curing/CuringBox/LiveBox 1/PDMS parts/3x1.SLDPRT

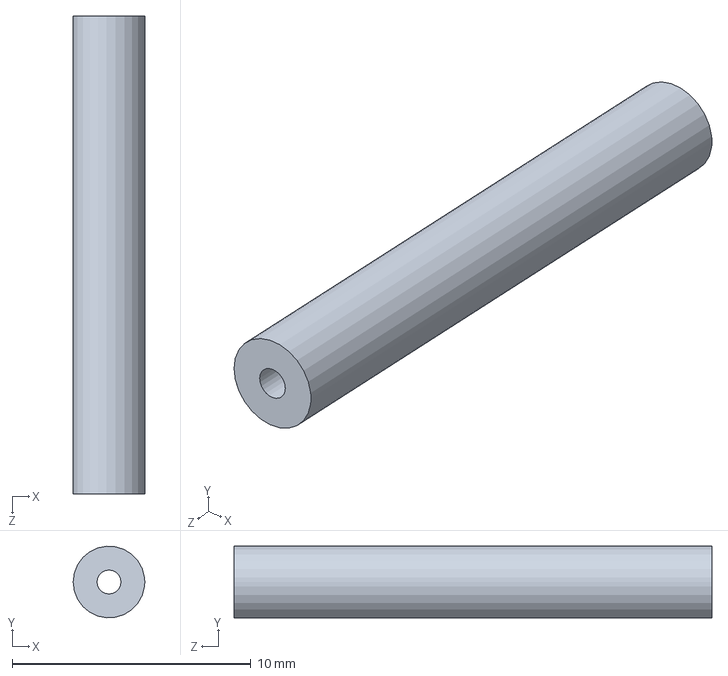
[picture p65: CAD file, 2013-10-29]
CuringBox/LiveBox 1/PDMS parts/3x1.SLDPRT
3.00 x 2.99 x 20.0 mm
