Balestrino/UV-Curing/DrivingBox/arduino nano290313/reset shell.SLDPRT

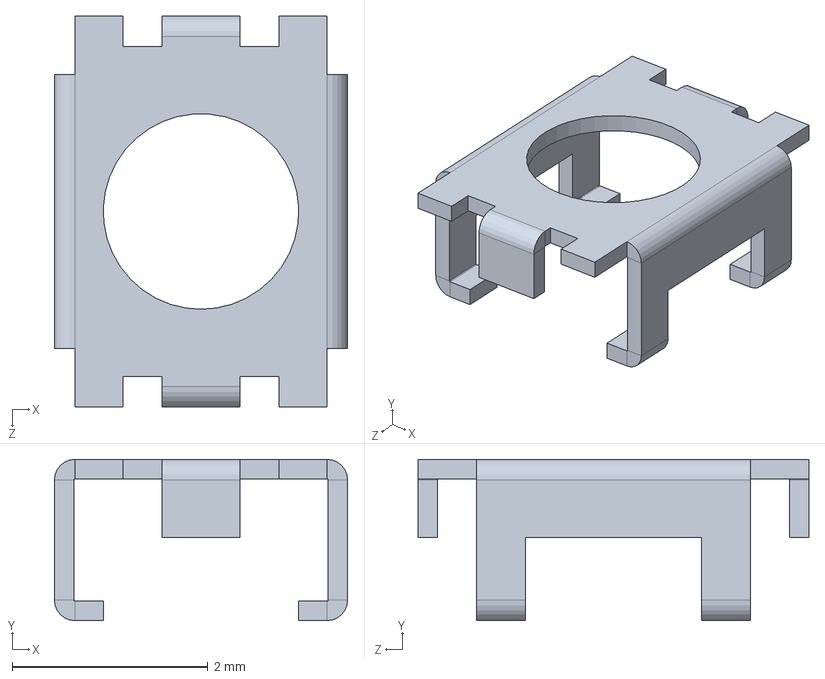
[picture p66: CAD file, 2013-10-29]
DrivingBox/arduino nano290313/reset shell.SLDPRT
3.00 x 1.65 x 4.00 mm
