Balestrino/UV-Curing/CuringBox/Bioreactor holder/Column.SLDPRT

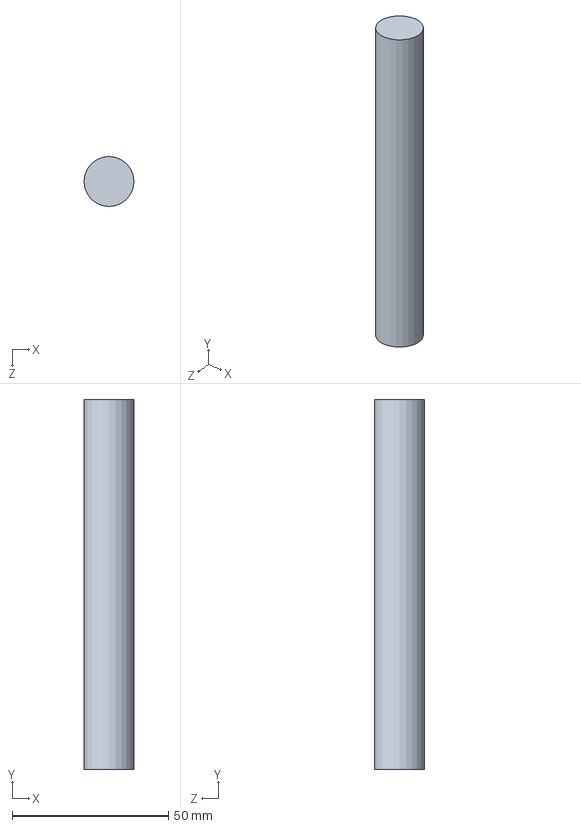
[picture p67: CAD file, 2013-10-29]
CuringBox/Bioreactor holder/Column.SLDPRT
16.0 x 118.5 x 16.0 mm
