Balestrino/UV-Curing/DrivingBox/arduino nano290313/15pin_header__.sldprt

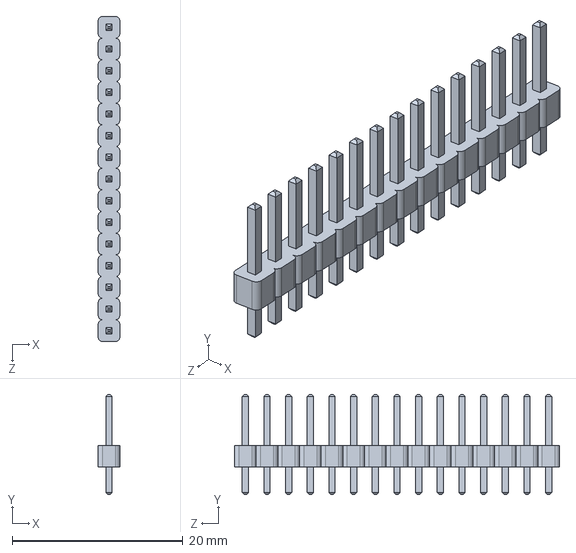
[picture p68: CAD file, 2013-10-29]
DrivingBox/arduino nano290313/15pin_header__.sldprt
2.54 x 11.8 x 38.1 mm
