Balestrino/UV-Curing/DrivingBox/arduino nano290313/189 RESISTOR PACK.SLDPRT

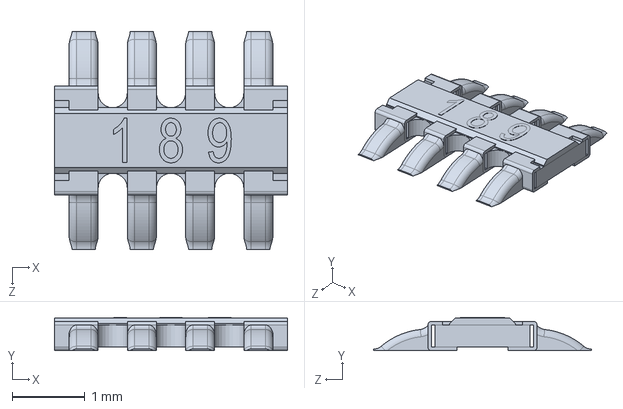
[picture p69: CAD file, 2013-10-29]
DrivingBox/arduino nano290313/189 RESISTOR PACK.SLDPRT
3.20 x 0.455 x 3.00 mm
