Balestrino/UV-Curing/DrivingBox/arduino - disegna USB.SLDPRT

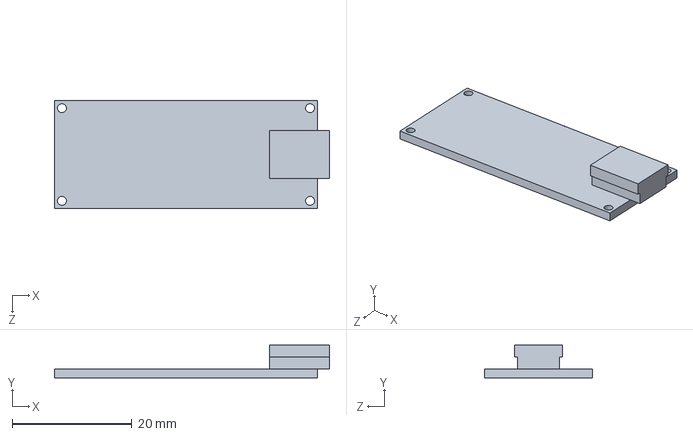
[picture p70: CAD file, 2013-10-29]
DrivingBox/arduino - disegna USB.SLDPRT
46.0 x 5.50 x 18.0 mm
