Balestrino/UV-Curing/DrivingBox/arduino nano290313/NANO DIODE.SLDPRT

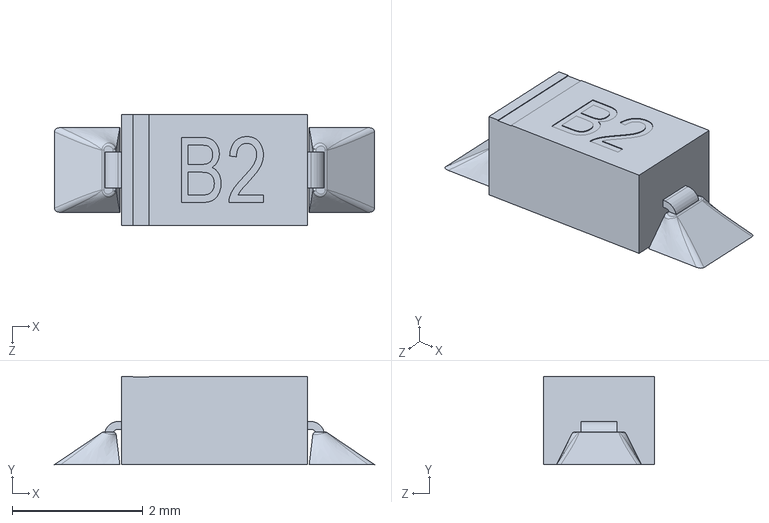
[picture p71: CAD file, 2013-10-29]
DrivingBox/arduino nano290313/NANO DIODE.SLDPRT
4.90 x 1.35 x 1.70 mm
