Balestrino/UV-Curing/DrivingBox/arduino nano290313/MINI USB CONTACT.SLDPRT

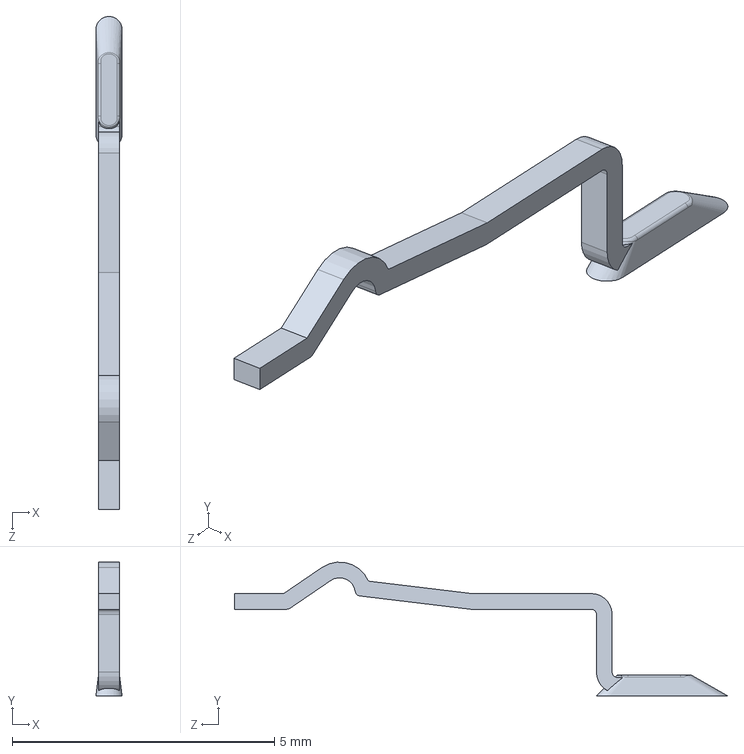
[picture p72: CAD file, 2013-10-29]
DrivingBox/arduino nano290313/MINI USB CONTACT.SLDPRT
0.5 x 2.55 x 9.40 mm
