Balestrino/UV-Curing/DrivingBox/LED-driver.SLDPRT

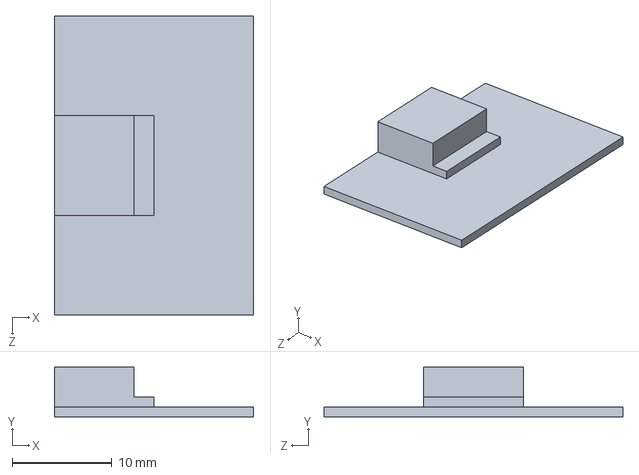
[picture p73: CAD file, 2013-10-29]
DrivingBox/LED-driver.SLDPRT
20.0 x 5.00 x 30.0 mm
