Balestrino/UV-Curing/DrivingBox/arduino nano290313/MINIUSBSHELL.SLDPRT

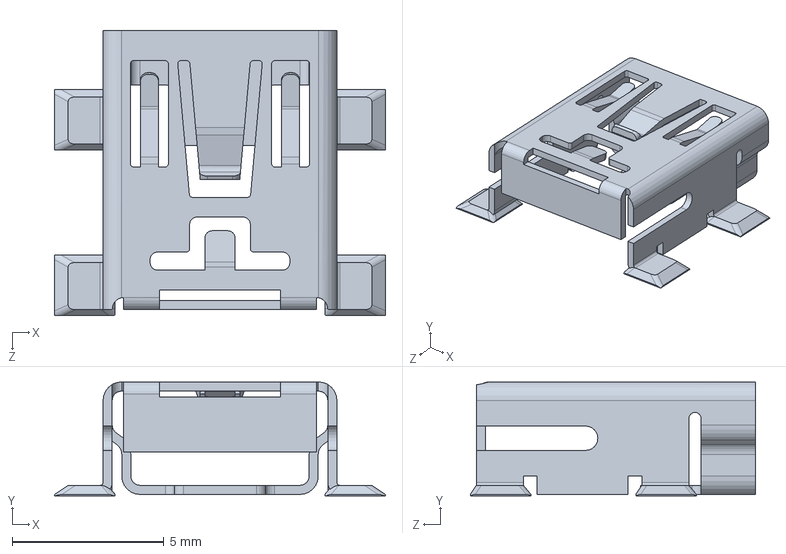
[picture p74: CAD file, 2013-10-29]
DrivingBox/arduino nano290313/MINIUSBSHELL.SLDPRT
10.9 x 3.75 x 9.40 mm
