Balestrino/UV-Curing/DrivingBox/Arduino.SLDPRT

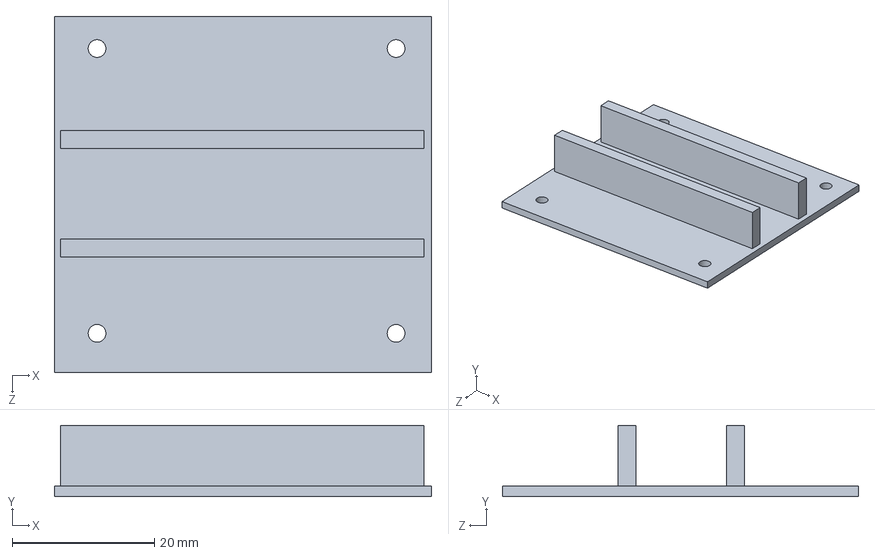
[picture p75: CAD file, 2013-10-29]
DrivingBox/Arduino.SLDPRT
53.0 x 10.0 x 50.0 mm
