Balestrino/UV-Curing/DrivingBox/arduino nano290313/smt_resistor222.sldprt

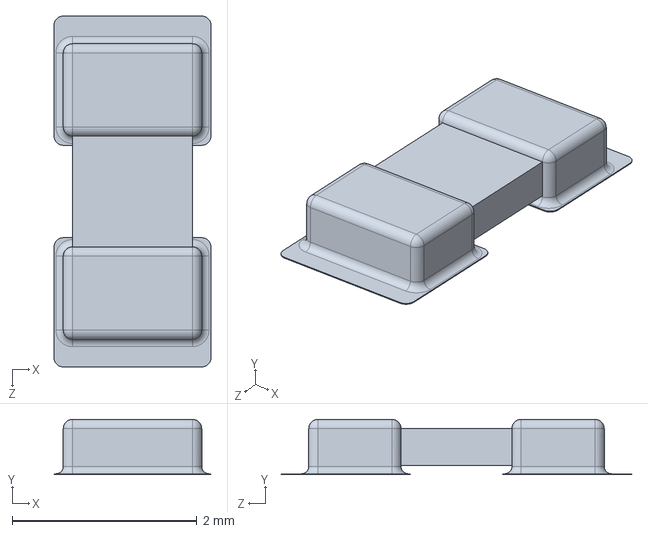
[picture p76: CAD file, 2013-10-29]
DrivingBox/arduino nano290313/smt_resistor222.sldprt
1.70 x 0.6 x 3.80 mm
