Balestrino/UV-Curing/DrivingBox/arduino nano290313/16mhz crystal - measured.SLDPRT

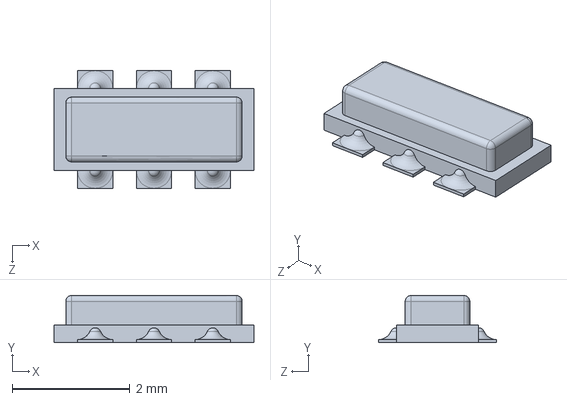
[picture p77: CAD file, 2013-10-29]
DrivingBox/arduino nano290313/16mhz crystal - measured.SLDPRT
3.40 x 0.8 x 2.00 mm
