Balestrino/UV-Curing/DrivingBox/LCD display.SLDPRT

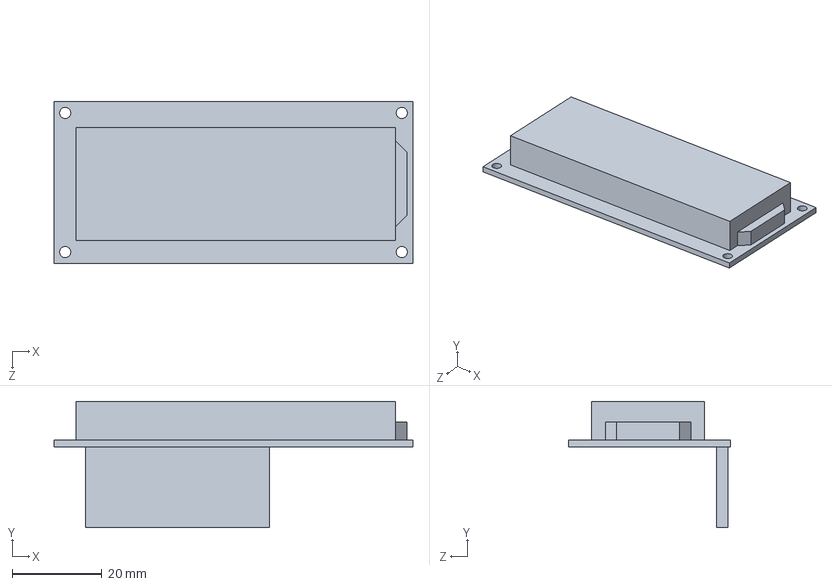
[picture p78: CAD file, 2013-10-29]
DrivingBox/LCD display.SLDPRT
80.0 x 28.1 x 36.0 mm
