Balestrino/UV-Curing/DrivingBox/arduino nano290313/MINI USB SOLDER.SLDPRT

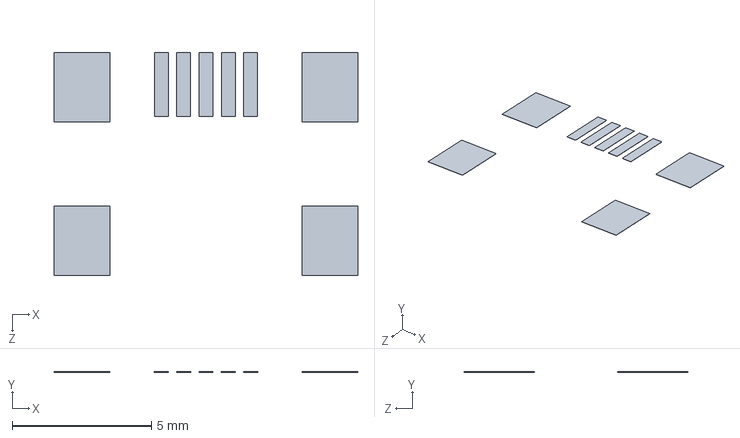
[picture p79: CAD file, 2013-10-29]
DrivingBox/arduino nano290313/MINI USB SOLDER.SLDPRT
10.9 x 0.01 x 8.00 mm
