Balestrino/UV-Curing/DrivingBox/arduino nano290313/ftdi FT232rl.SLDPRT

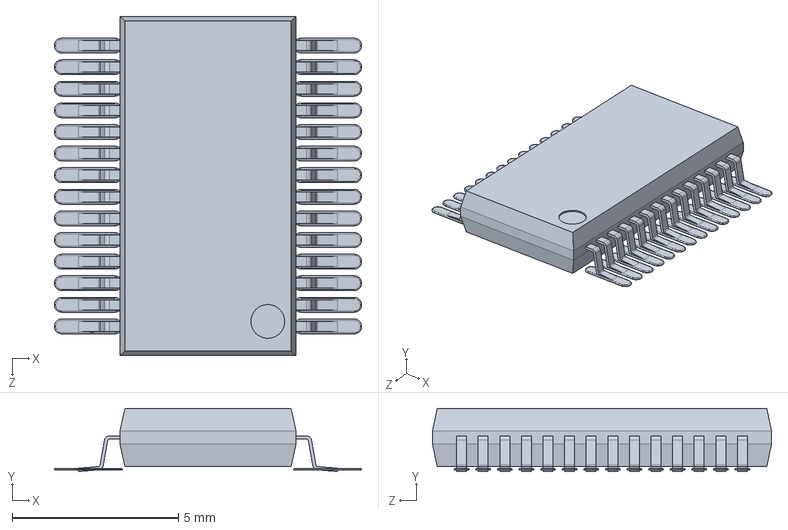
[picture p80: CAD file, 2013-10-29]
DrivingBox/arduino nano290313/ftdi FT232rl.SLDPRT
9.25 x 1.90 x 10.2 mm
