Balestrino/UV-Curing/DrivingBox/arduino nano290313/nano-board.SLDPRT

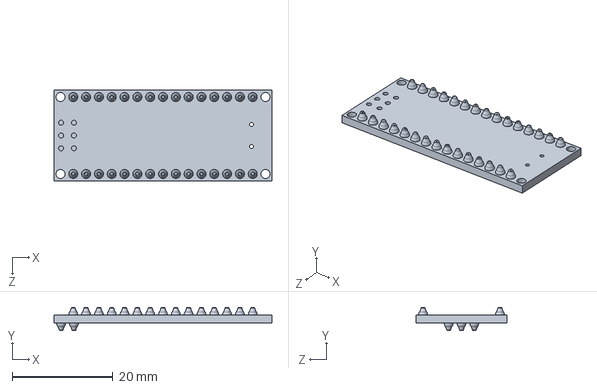
[picture p81: CAD file, 2013-10-29]
DrivingBox/arduino nano290313/nano-board.SLDPRT
43.2 x 4.60 x 18.0 mm
