Balestrino/UV-Curing/DrivingBox/arduino nano290313/reset core.SLDPRT

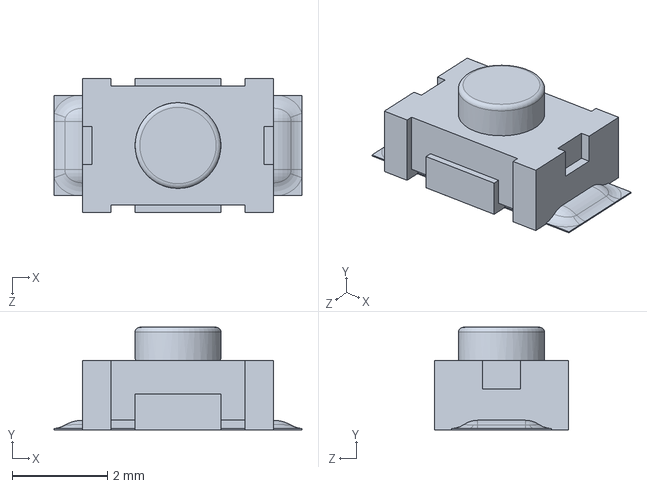
[picture p82: CAD file, 2013-10-29]
DrivingBox/arduino nano290313/reset core.SLDPRT
5.20 x 2.15 x 2.80 mm
