Balestrino/UV-Curing/DrivingBox/arduino nano290313/nano - reg.SLDPRT

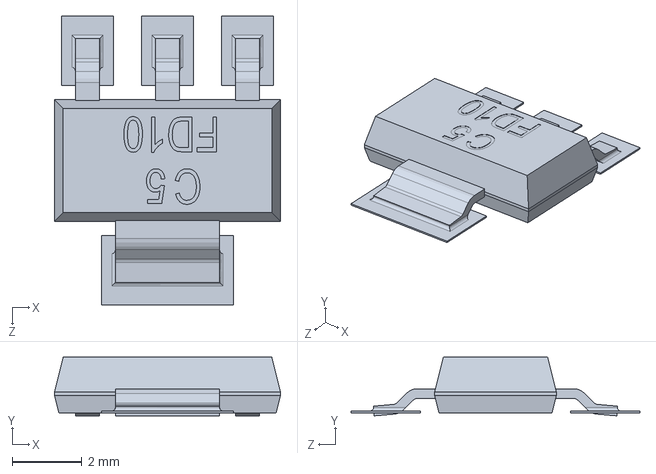
[picture p83: CAD file, 2013-10-29]
DrivingBox/arduino nano290313/nano - reg.SLDPRT
6.50 x 1.69 x 8.30 mm
