Balestrino/UV-Curing/(list of files, cad)

Other CAD files:
CuringBox/TB/TB-Top.SLDASM
CuringBox/Bioreactor holder/3D view live box 1.SLDASM
CuringBox/Bioreactor holder/Bioreactor base.SLDPRT
DrivingBox/Base.SLDPRT
CuringBox/Bioreactor holder/Bioreactor holder.SLDPRT
CuringBox/Light source/Giorgio-Base-HiRes.STL
DrivingBox/top.SLDPRT
CuringBox/Bioreactor holder/cilindro PDMS.SLDPRT
CuringBox/LiveBox 1/mycroscope clamp colonna.SLDPRT
DrivingBox/Giorgio-top-HiRes.STL
CuringBox/Bioreactor holder/mycroscope clamp base.SLDPRT
DrivingBox/Giorgio-Base-HiRes.STL
DrivingBox/arduino nano290313/102 RESISTOR PACK.SLDPRT
CuringBox/LiveBox 1/File .STL/Base componente bottom.STL
CuringBox/LiveBox 1/File .STL/Base componente centrale.STL
