Balestrino/UV-Curing/CuringBox/LiveBox 1/PDMS assembly/3D view live box 1 esploso.PDF

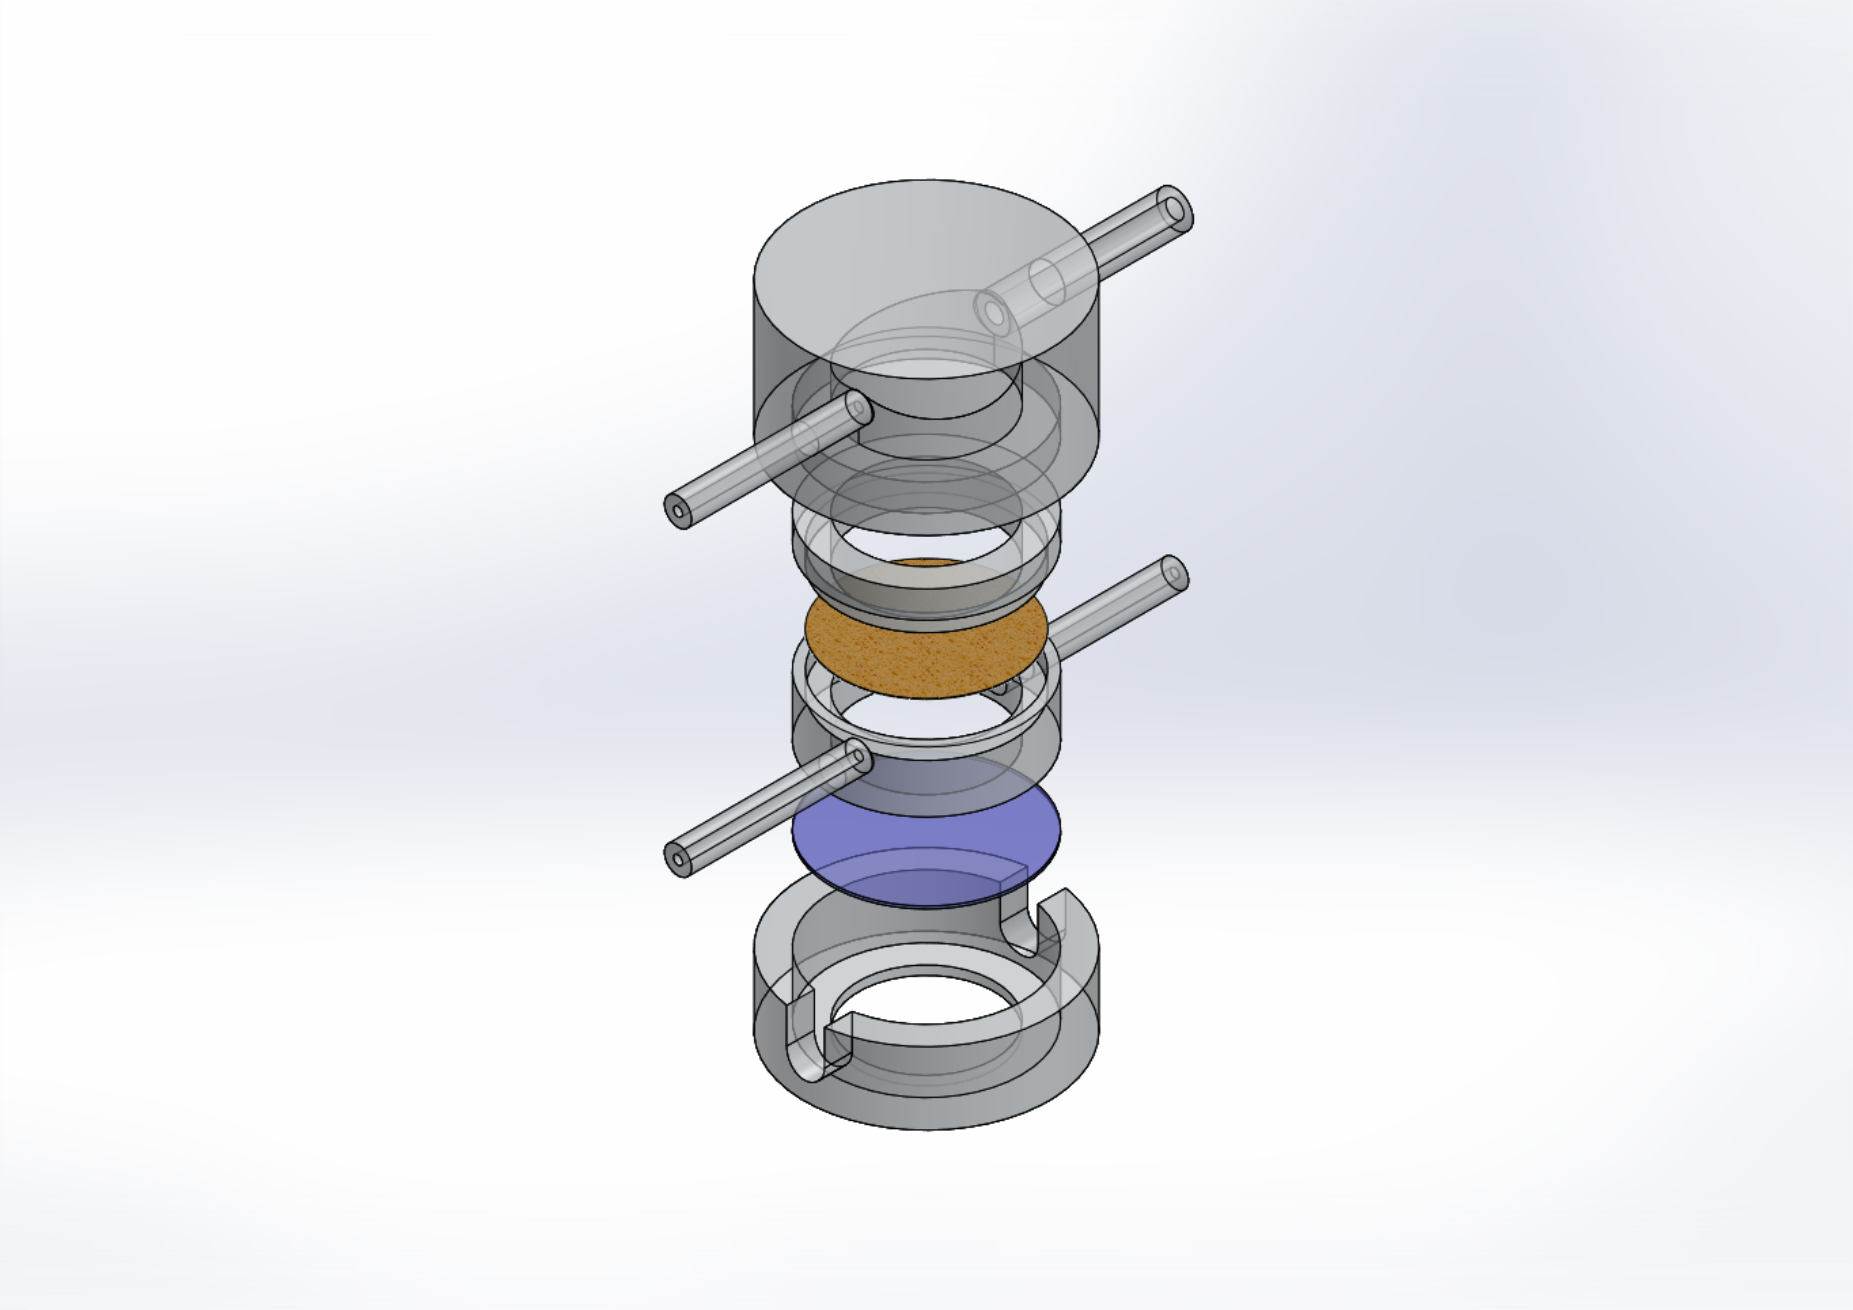
[picture p84: page 1]
