Balestrino/UV-Curing/CuringBox/LiveBox 1/PDMS assembly/3D view live box 1.PDF

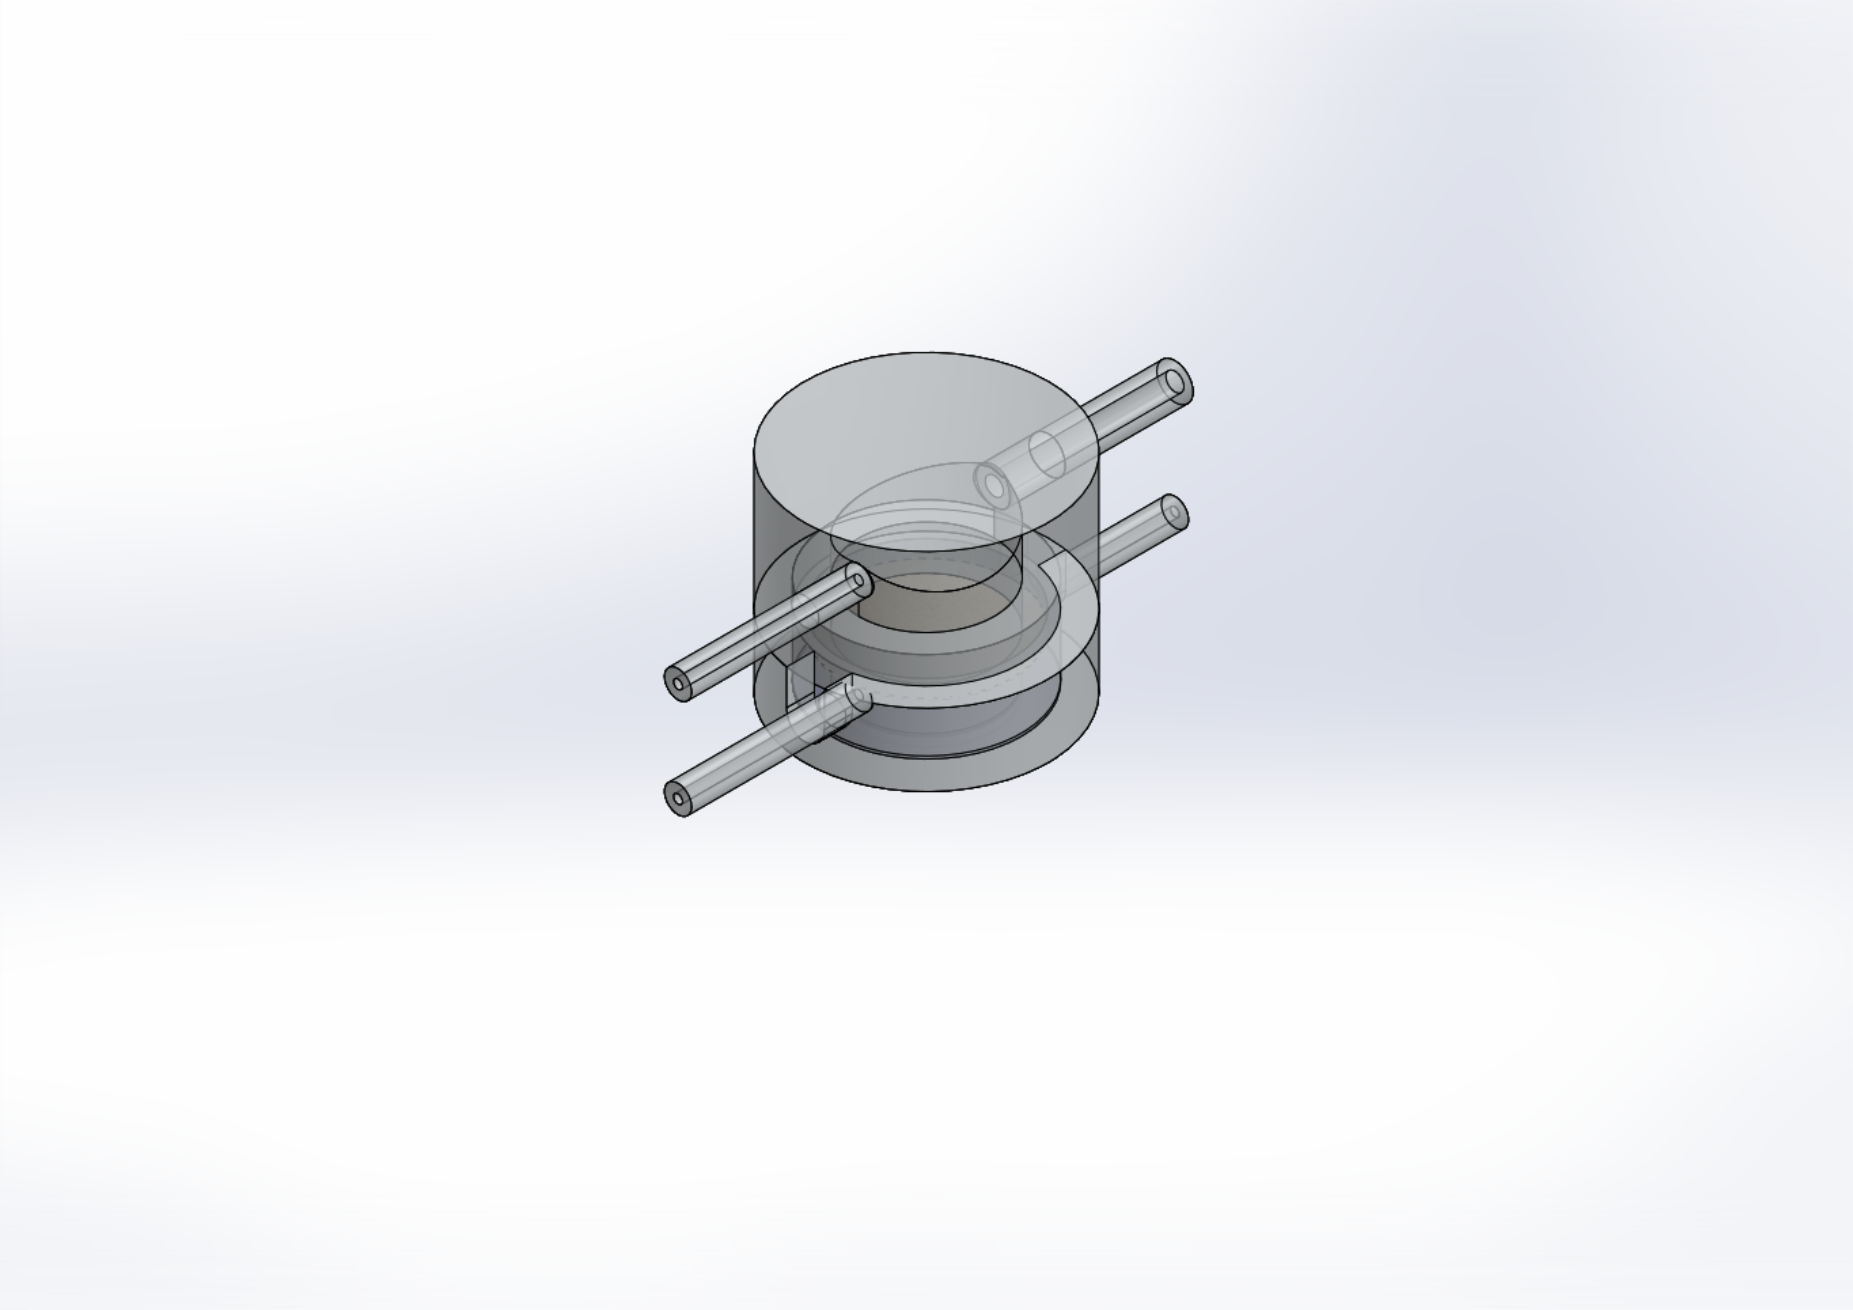
[picture p85: page 1]
